CappyT/freedo/docs/API.md

# HTTP API reference

The freedo daemon serves a JSON API over HTTP. The Home Assistant integration uses it.
Any other client can use it too.

This file lists every route that `internal/daemon` registers and the rules that apply to
the routes. For the radio facts behind a rule, see [PROTOCOL.md](PROTOCOL.md).

## Conventions

### Address and authentication

- The daemon listens on `http_listen` (default `127.0.0.1:8080`). The flag `--addr` overrides it.
- Every request under `/api` carries `Authorization: Bearer <token>`. The daemon serves the
  [dashboard](OPERATION.md#dashboard) at every other path, without a token.
- The daemon reads the token from one source, in this order: the file of `--api-token-file`,
  the variable `FREEDO_API_TOKEN`, the file of the key `api_token_file`.
- The daemon removes spaces at both ends of the token. An empty token stops the start.
- The daemon compares tokens in constant time. A missing or wrong token gets `401` with
  `WWW-Authenticate: Bearer`.
- `--health-public` makes `GET /api/health` readable without a token, for a container
  health check. The default is off.
- `--ingress` makes the daemon accept the calls of the dashboard from the connection address
  `172.30.32.2`, the Home Assistant ingress gateway, without a token. It covers 59 method and path
  pairs only. Only the add-on start script sets it, and it has no effect unless `SUPERVISOR_TOKEN` is
  set. With the flag, the gateway also reaches the two routes of the
  [state export and import](#state-export-and-import) for a Home Assistant administrator. Every other
  request needs the token. See [Access](OPERATION.md#access).
- With no token, the daemon accepts a loopback address only and warns at start. An address
  that is not loopback stops the start. `--insecure-no-auth` removes this limit. With it,
  every host that reaches the port controls the plant.

To create a token:

```sh
openssl rand -hex 32 > freedo_api_token
chmod 600 freedo_api_token
curl -H "Authorization: Bearer $(cat freedo_api_token)" http://127.0.0.1:8080/api/stats
```

### Requests and answers

- A JSON body holds one value and no field that the route does not know. An unknown field
  or a second value gets `400`. A body over 64 KiB gets `413`. The limit is 1 MiB for
  firmware upload and for the debug routes.
- The server closes a connection that sends no complete header in 10 seconds.
- When a client closes a request, the daemon stops to wait for the engine and answers `503`.
  A command that the engine already took still runs.
- A command that cannot save its state in the database gets `500`.
  `PATCH /api/home`, the [program preset](#program-presets) routes, `PUT` and
  `DELETE /api/zones/{n}/schedule` and `POST /api/zones/{n}/window` store their state
  before they change the engine state. After a `500` the engine state is unchanged.
- A write that queues a radio message answers with the queue state of the target device.
  `GET /api/queue/{id}` shows the queue and the history, with the result of each message.
  A newer write to the same zone replaces a queued one that is not yet on air. The history
  shows the replaced message as `superseded`.
- After a `5.xx` answer from a device, the daemon repeats the write with a new message id
  and token.
- The daemon exits with code 1 when the live radio loop ends on an error. The service
  manager or the container restart policy then starts it again. The API keeps serving
  after a replay ends.

### Installation writes

Every write under `/api/install` answers `{"rev": N, "warnings": [...], <object>}`. Each
write accepts `rev` as an optimistic concurrency token. The label of a device is unique:
a write that repeats the label of another device gets `409` and names that device.
A delete that breaks a reference gets `409` and names the row that holds the reference.

Four routes carry a part of a wider route: `PUT /api/install/timezone`, `PUT /api/install/boiler`,
`PUT /api/install/devices/{ref}/label` and `PUT /api/install/devices/{ref}/zone`. They follow the rules
of the wider route and refuse every other field. `PUT /api/install/boiler` carries the options of the
boiler and of its flow limit: `boiler_max_power_kw`, `boiler_min_power_kw`, `boiler_max_gas_m3h`,
`boiler_min_gas_m3h`, `fuel_unit`, `flow_limit_c`, `flow_default_curve`, `flow_auto_adapt`,
`flow_curves`, `outdoor_max_age_sec`, `flow_hysteresis_c` and `flow_min_interval_sec`. A body with none
of them is `400`. `POST /api/pair/devices/{ref}` is `POST /api/pair`
with the target in the path and no `networkKeyHex`. The dashboard calls these, so
[Home Assistant ingress](../SECURITY.md#home-assistant-ingress) reaches them without a token and
does not reach the identity of the network or another network key.

`GET /api/install/devices/{ref}/removal` answers `{"rev", "device", "effects", "forceable"}`. It shows
what `DELETE` on the same device changes. Each entry of `effects` is `{"effect", "zone"}` or
`{"effect", "circuit"}`:

| Effect | Meaning |
|---|---|
| `member` | The zone loses the device as a member. One entry for each zone of the device. |
| `hot_water` | The zone is the hot water zone. |
| `last_member` | The zone has no member left. |
| `reporter` | The zone loses its demand reporter. |
| `measuring_device` | The zone loses the device that gives its temperature. |
| `heat_source` | The circuit loses its heat source. |

`DELETE` without `?force=true` gets `409` with the same `effects` while the list is not empty.
`force=true` releases the zone memberships. It never releases a heat source: `forceable` is `false`
then, and the circuit must change first. An empty list means that the delete needs no force.

### Credentials in answers

No route outside `/api/debug/*` and `GET /api/state/export` returns a credential. The credentials
are the device token, the session id, the challenge keys and the network key. The
[state export](#state-export-and-import) is the whole database, so it holds all of them.

- `Telemetry` of `/api/nodes` omits `auth_token`, `serial_id`, `cloud_session_id`,
  `challenge_key_rotate` and `0262`.
- `SessionIssued`, `SessionAdopted` and `SessionIssuedUnix` tell whether and when the daemon
  served a session. They do not carry the id. `SessionIssuedUnix` is the time the daemon last built
  an answer to `auth/token` or `auth/key`. A request that repeats the message id of the last one gets
  the stored answer, and the time does not move, so the time can be older than the last join.
  `SessionAdopted` has no time: it turns false when the daemon builds a new answer and true when a
  later request carries the session id. A device that leaves the installation loses the time and keeps
  `SessionIssued`.
- `GET /api/install` reports `network_key.present`. `PUT /api/install/network_key` and the
  field `networkKeyHex` of `POST /api/pair` receive the key and never return it.
- `GET /api/nodes/{id}/resource`, `/dbg/mem` and `/currentlog` return the raw device answer
  in hexadecimal, without a filter.

Identifiers are not credentials. The serial number, the EUI, the home id and the
coordinator EUI appear in `/api/install/*`, in `Serial` of `/api/nodes` and in the start
banner.

## Routes

`{id}` names a device by label, serial number or short address. `{n}` is a zone number.
`{ref}` names a device the same way.

### Read

| Route | Purpose |
|---|---|
| `GET /api/health` | State of the daemon, the radio and the devices, with alerts. |
| `GET /api/nodes`, `GET /api/nodes/{id}` | Devices with telemetry, battery, faults and settings. |
| `GET /api/zones` | Zones with members, demand, target, window state and external temperature. |
| `GET /api/circuits` | Heating circuits as the engine sees them. |
| `GET /api/boiler` | Boiler values, flow limit state, energy and gas estimate. |
| `GET /api/home` | Home and away state, the scheduled setpoint of each zone and the active preset. |
| `GET /api/stats` | Frame counters, node count and unhandled counts. |
| `GET /api/unhandled` | Counts of unhandled radio events by reason. |
| `GET /api/queue/{id}` | Queue and history of a device. |
| `DELETE /api/queue/{id}` | Drop the queue of a device. |
| `GET /api/early-start` | Early start state of all zones. |
| `GET /api/heatsource/capabilities` | Reads the heat source capabilities from the [boiler thermostat](#boiler-thermostat). |

### Zone commands

| Route | Purpose |
|---|---|
| `POST /api/zones/{n}/setpoint` | Set a manual overlay. |
| `POST /api/zones/{n}/off` | Switch the zone off with an overlay. |
| `POST /api/zones/{n}/auto` | Return the zone to its program. |
| `POST /api/zones/{n}/boost` | Start or stop the boost of a room. |
| `POST /api/zones/{n}/offset` | Set the temperature correction. |
| `POST /api/zones/{n}/window` | Open or close the window state from an outside source, or reset it. |
| `POST /api/zones/{n}/temperature`, `DELETE ...` | Give or remove an external room temperature. |
| `GET`, `PUT`, `DELETE /api/zones/{n}/schedule` | Read, write or remove the weekly program of one mode of one preset. |
| `GET`, `POST /api/presets` | List the program presets, create one. |
| `PATCH`, `DELETE /api/presets/{id}` | Rename or delete a preset. |
| `POST /api/presets/{id}/activate` | Switch the active preset. |
| `GET /api/presets/{id}/schedules` | Read every program of one preset, zone by zone. |
| `GET`, `PUT /api/zones/{n}/early-start` | Read or switch the early start. |
| `DELETE /api/zones/{n}/early-start/model` | Delete the learned heat-up model. |
| `GET /api/zones/{n}/episodes` | Recorded heating and cooling episodes. |
| `GET /api/zones/{n}/pid-suggestion` | Suggested controller gains from the episodes. |
| `PATCH /api/home` | Switch the whole home between home and away. |

### Device commands

| Route | Purpose |
|---|---|
| `POST /api/nodes/{id}/setpoint` | Low-level setpoint write to one device. |
| `POST /api/nodes/{id}/mode`, `.../overlay` | Low-level overlay mode (`overlay` is an alias). |
| `POST /api/nodes/{id}/openwindow`, `.../ow` | Low-level window write (`ow` is an alias). |
| `POST /api/nodes/{id}/boost` | Low-level boost. |
| `POST /api/nodes/{id}/childlock` | Lock or unlock the controls of a valve. |
| `GET`, `PUT /api/nodes/{id}/display` | Read or write the display settings of a valve. |
| `POST /api/nodes/{id}/identify`, `.../beep` | Make a valve or the wall thermostat signal itself (`beep` is an alias). |
| `POST /api/nodes/{id}/calibrate` | Start the motor calibration of a valve. |
| `POST /api/nodes/{id}/reboot` | Restart a device. The body is `{}` or `{"id": N}`. The device keeps its key and joins again. |
| `POST /api/nodes/{id}/extui` | Write the external interface endpoints. |
| `POST /api/nodes/{id}/config` | Write chosen `d/config` tags. |
| `DELETE /api/nodes/{id}/config/offlineScheduleEnabled` | Remove the per-device offline schedule value. |
| `PUT /api/nodes/{id}/schedule` | Write the home program of the heating zone of a device, or the document of a device in no heating zone. |
| `GET`, `POST`, `DELETE /api/nodes/{id}/fw` | Read the firmware state, start or cancel a transfer. |
| `GET /api/nodes/{id}/currentlog` | Read the device log. |
| `GET /api/nodes/{id}/dbg/mem?adr=&len=` | Read device memory (`refresh=1` forces a new read). The read stays inside flash `0-7ffff`, FICR and UICR `10000000-10001fff`, SRAM `20000000-2000ffff` or external flash `80000000-ffffffff`. |
| `GET`, `POST /api/nodes/{id}/dbg/stats?f=` | Valve debug statistics, `f=10` for the state times or `f=11` for the radio counters. `POST` queues `POST d/dbg/m?f=N`. `GET` sends nothing: it answers `pending`, the code of the last answer, and the last 2.05 decoded under `stats` with its `received_at`. The code `2.05+more` marks an answer that announces more Block2 blocks: freedo does not follow it, because a new POST would run the function again. For `f=10`, `share` gives the awake, TX and RX time in percent between the last two 2.05 answers. It is absent when they are 36 h apart or more, or when their awake and sleep ticks disagree with the clock of the daemon by more than 10 s plus 10 %, as after a restart of the valve. For `f=11`, `delta` gives `interval_s` and the change of each counter between the last two 2.05 answers, without `023d` and `023e`. Most counters carry their low 16 bits and wrap at 65536, so a single value counts from an unknown start: only the change means something. A restart of the valve, or 65536 counts or more between two answers, gives a wrong change. The wall thermostat is refused. |
| `GET /api/nodes/{id}/resource?path=&query=` | Read any resource of a device, except `d/dbg/m`. |

### Boiler, environment and pairing

| Route | Purpose |
|---|---|
| `POST /api/boiler/dhw` | Set the hot water temperature overlay. |
| `POST /api/boiler/flow` | Set the flow limit of a circuit (the [boiler thermostat](#boiler-thermostat) by default). |
| `POST`, `DELETE /api/boiler/gas/meter` | Record or remove a gas meter reading. |
| `POST /api/outdoor` | Give the outdoor temperature. |
| `GET`, `POST /api/pair/window` | Read, open or close the pair window. |
| `POST /api/pair` | Send the `d/pair` command to a device. |
| `POST /api/pair/devices/{ref}` | Send the `d/pair` command to the named device, under the network key of the installation. No body. |
| `POST /api/radio/calibrate` | Forget the stored receiver calibration and measure it again. No body. |

### Statistics

| Route | Purpose |
|---|---|
| `GET`, `PUT /api/history` | Read or change the statistics: the switch, the fuel price and the currency. |
| `GET /api/history/zones/{number}?date=` | The samples and the heat-ups of one zone over one local day. |
| `GET /api/history/energy?from=&to=` | The fuel, heat and burner totals of each day. |
| `GET /api/history/advice?days=` | Where the fuel of the last 7, 28 or 90 days went, and the heat-loss model of the house. |

See [Statistics](#statistics).

### Installation

| Route | Purpose |
|---|---|
| `GET`, `PATCH /api/install` | Read or change the installation and its options. |
| `PUT /api/install/network_key` | Write the network key (only while no device is declared). |
| `PUT /api/install/timezone` | Write the time zone alone: `{"timezone": "Europe/Rome"}`, `null` to follow the host. |
| `PUT /api/install/boiler` | Write the boiler and flow limit options alone: see [Installation writes](#installation-writes). |
| `GET`, `POST /api/install/devices` | List or declare devices. |
| `GET`, `PATCH`, `DELETE /api/install/devices/{ref}` | Read, change or delete a device. |
| `PUT /api/install/devices/{ref}/label` | Rename a device: write the label alone. |
| `PUT /api/install/devices/{ref}/zone` | Write the zone the device answers to, alone: `{"zone": 3}`, `null` to remove it. |
| `GET /api/install/devices/{ref}/removal` | Show what a removal changes. |
| `GET`, `POST /api/install/zones` | List or declare zones. |
| `GET`, `PATCH`, `DELETE /api/install/zones/{number}` | Read, change or delete a zone. |
| `PUT`, `POST /api/install/zones/{number}/members` | Replace the members, or add one. |
| `DELETE /api/install/zones/{number}/members/{ref}` | Remove one member. |
| `PUT`, `DELETE /api/install/zones/{number}/reporter` | Set or clear the demand reporter. |
| `PUT`, `DELETE /api/install/zones/{number}/measuring` | Set or clear the measuring device. |
| `GET`, `POST /api/install/circuits` | List or declare circuits. |
| `GET`, `PATCH`, `DELETE /api/install/circuits/{id}` | Read, change or delete a circuit. |

### State

| Route | Purpose |
|---|---|
| `GET /api/state/export` | Download a snapshot of the state database, as one file. |
| `POST /api/state/import?confirm=true` | Replace the state database with an exported file and restart the daemon. |

See [State export and import](#state-export-and-import).

### Debug

`--debug-api` or `debug_api: true` enables these routes. They decrypt any frame that a
caller sends and stream live traffic. Leave them off in normal use.

| Route | Purpose |
|---|---|
| `POST /api/debug/dissect` | Interpret a frame. |
| `POST /api/debug/decrypt` | Decrypt a frame. |
| `GET /api/debug/rx` | Stream received frames. |

## Installation model

A device is a physical node. A zone is a room or the hot water service. A circuit joins
one or more zones to a heat source. The three have separate identifiers.

- A heating zone holds valves. It can hold a wall thermostat as the measuring device.
- The hot water zone holds the wall thermostat.
- `measuring_device` selects the measurement the zone uses. `reporter` selects the member
  that publishes the aggregated demand. The loader rejects a missing or ambiguous reference.
- A zone number can be sparse. A valve answers to one logical zone number. The `zone` field
  of the device states it. The circuit number does not depend on the zone number.
- A circuit needs a heat source, and the heat source must be a wall thermostat. A heating
  zone should have a circuit. Without one, the zone configuration for its valves has no
  circuit tag `6060` and no heat source among the members, and the install check warns about
  the zone. No device has run a zone configuration of this kind.
- The order of the members matters: the zone configuration document has other bytes with
  another order.

The installation is stored in the SQLite database. The tables are `install` (key-value
options), `net_key`, `device`, `circuit`, `zone` and `zone_member`. Each write is one
transaction that applies the rows, rebuilds the installation, validates it and raises
`install_rev`. The engine gets the installation after the commit.

The database holds more than the installation. It also keeps the desired state of the
devices and the learned state. These are the away state, the program presets with the home
and away programs of each zone, the program
blocks of each zone, the early start models, the adapted flow limits, the last external
room temperature of each zone the coordinator owns, the boiler counters, the resume points of the frame counters
and the radio calibration. The node state, the learned zone members and the command queue
are caches. Device reports rebuild them, so a restart repairs them.

The database uses the pure Go driver `modernc.org/sqlite`, WAL mode and
`synchronous=FULL`. It migrates forward only. A damaged, foreign or newer database stops
the start with an error. `SIGTERM` and `SIGINT` run the same orderly stop. It ends in
less than nine seconds, below the ten seconds of `docker stop`.

On the first start with an empty database, the daemon creates the 16-byte network key, the
coordinator EUI and a home id. It never prints the key. A network key that differs from
the one of an existing network makes every frame of that network fail the MIC check.

### Installation options

`PATCH /api/install` writes these options. A `null` removes the value where the option
allows it.

| Option | Default | Meaning |
|---|---|---|
| `home_id`, `coordinator` | generated | Identity of the network. Change only while no device is declared. |
| `utc_offset_min`, `timezone` | host zone | Clock of the devices (tag `02b2`) and of the programs. A set `utc_offset_min` wins over `timezone`, and a loadable `timezone` (IANA name) wins over the host zone. `GET /api/health` shows the source in `timezone`. |
| `utc_push_spacing_sec` | 60 | Spacing of the offset writes to the valves. Each write homes the motor. |
| `offline_schedule` | `true` | Tag `02b3` for every device without its own value. |
| `external_window_max_sec` | 7200 | Cap of a window state from an outside source. |
| `room_temp_max_age_sec` | 1800 | Age at which an external room temperature expires. |
| `low_battery_cell_mv` | 1100 | Battery alarm threshold per cell. |
| `offline_after_sec` | 3600 | Silence after which a device is `offline`. |
| `flow_limit_c` | none | Flow limit of every circuit that no manual value, curve or adaptation sets, 30 to 75 C. It is also the manual maximum that the default curve reduces. While it is unset, such a circuit is served no limit: see [Flow limit](#flow-limit). A `null` clears it. |
| `outdoor_max_age_sec` | 3600 | Age at which the outdoor temperature expires. |
| `flow_hysteresis_c`, `flow_min_interval_sec` | 1, 1800 | Smallest change and shortest interval of the served flow limit. |
| `flow_curves`, `flow_auto_adapt` | none, `false` | Weather curve per circuit, and the automatic adaptation. |
| `flow_default_curve` | `false` | Built-in weather curve for every circuit without a curve of its own. It needs `flow_limit_c`: see [Flow limit](#flow-limit). |
| `early_start_min_episodes`, `early_start_max_lead_sec` | 3, 7200 | Early start thresholds. |
| `boiler_max_power_kw`, `boiler_min_power_kw` | none, 0 | Boiler output at 100 % and 0 % modulation. |
| `boiler_max_gas_m3h`, `boiler_min_gas_m3h` | none | Fuel flow at 100 % and 0 % modulation, in `fuel_unit` per hour. |
| `fuel_unit` | `m3` | Unit of the fuel flow and counter: `m3`, `l` or `kg`. `null` takes `m3`. |
| `router_gateway`, `router_dns` | `0.0.0.0` | IPv4 gateway and DNS address that the Router Advertisement carries, as dotted quads. `null` or an empty string takes `0.0.0.0`. Not verified on a device. |

### Zone options

`PATCH /api/install/zones/{number}` writes these options.

| Option | Default | Meaning |
|---|---|---|
| `open_window_detection`, `open_window_duration_sec` | `true`, 900 | Window detection of the valves and the time the zone stays open. |
| `early_start` | `false` | Early start for the zone. |
| `device_overlay_end`, `device_overlay_end_sec` | `until_next` | End rule of a change made on a device: `manual`, `until_next` or `timer` with a duration. |
| `offset_mode` | `config` | How the temperature correction reaches the zone: `config` or `dbg2`. |
| `owner` | `device` | Who owns the zone: `device` (the elected demand reporter) or `coordinator`, which runs the zone controller on the external room temperature. Only a heating zone takes it. Unverified on air. |
| `pid` | 1000, 500, 1500 | Controller gains `kp`, `ki`, `kd` of the valve, each 0 to 65535. `kp` and `ki` cannot both be 0. `null` restores the defaults. |
| `away_temperature_c` | `null` | Temperature in away, 5 to 25 C with at most two decimals. `null` and 5 mean off in away. The hot water zone refuses it. An away program of the zone replaces the fixed temperature while the home is away. |
| `radiator_w` | `null` | Total nominal radiator power of the room in watts, the sum of the data-sheet values, 100 to 20000. `null` clears it. Optional. A consumption advisor uses it to split the consumption between rooms. The hot water zone refuses it. |
| `shared_space` | `null` | Short name of the air volume the room shares with other rooms (an open space): 1 to 32 characters of letters, digits, space, `-` or `_`, trimmed. `null` clears it. Optional. Zones with the same name share one air volume. The consumption advisor sums them for its heat-loss figure and gives one suggestion for the group. The fuel split still lists each zone. The hot water zone refuses it. |
| `ha_area` | `null` | Home Assistant area of the zone, `{"id": "...", "name": "..."}`, each 1 to 255 bytes with no control character. `null` clears it. The integration writes it and the dashboard shows it. The daemon never acts on it. `GET /api/zones` shows it in `declared[].haArea`. |

A `pid` change gives the zone document a new ETag and writes nothing to the valve. The
valve rereads the document after its hourly check, applies the gains and resets the
integrator. A change of `away_temperature_c` during away rewrites that zone at once when it
has no away program. A
change at home writes nothing and applies from the next away.

## Zones

### Zone commands

The daemon chooses the device to write. The commercial coordinator writes `z/s?id=N` only
to the reporter of the zone, even when the reporter is the wall thermostat. The other
members take the block from the echo of the reporter. A zone without a reporter and with
one member writes that member. With more members, `setpoint`, `off`, `auto` and `boost`
write every member. The answer then holds the members in `target`, separated by commas
(serial number, or EUI when a device has none), and the sum of their pending downlinks in
`pending`. The hot water zone writes the wall thermostat.

- `POST /api/zones/{n}/setpoint` with `{"setpointC": 21, "mode": "manual"}` sets an overlay.
  A room accepts 5 to 25 C. Hot water accepts 30 to 65 C.
  - `mode` is `manual`, `until_next`, `timer` (with `durationSec`) or `until_auto_change`.
  - `until_next` lasts until the next block of the program in force: in away, the away
    program of a zone that has one. Without a program in force it does not end.
  - `until_auto_change` lasts until the next program block or the next switch between home
    and away, whichever comes first. On air it is `6240=1`. A capture shows it for rooms.
    For hot water the value is not verified. The daemon keeps the rule and the deadline in
    the database. `device_overlay_end` does not accept it.
  - `timer` needs `durationSec`, 1 to 604800 (7 days). The other modes refuse it.
- `POST /api/zones/{n}/auto` returns the zone to its program.
- `POST /api/zones/{n}/off` with `{"mode": ...}` switches the zone off with an overlay
  (`6260=0`, no `6280`). `mode` takes the values of `setpoint`.
- `POST /api/zones/{n}/boost` with `{"on": true}` sets a room to 25 C for 30 minutes, then
  returns it to the program.
- `POST /api/nodes/{id}/setpoint` is the low-level form. It needs `tempC`. `tempC` and
  `sched` stay in 5 to 25 C, because a value outside wraps in the 16 bits of the tag.

### Overlays made on a device

A person who turns the wheel of a valve sends `PUT h/<home>/z/N/overlay`. The daemon answers
`2.05` and writes nothing. The end rule does not travel on air, so the daemon applies the
`device_overlay_end` rule of the zone:

- `manual` does not end.
- `until_next` ends at the next block of the program in force, the away program in away.
  Without one it does not end.
- `timer` ends after `device_overlay_end_sec`.

At the end, the daemon writes `6240=0` and the program setpoint to the writer of the zone.
`POST /api/zones/{n}/auto` cancels the overlay. The deadline survives a restart.

The elected reporter sends `DELETE h/<home>/z/N/overlay` when `6240` returns to 0 on the
device. The daemon answers `2.05`, returns the zone to automatic, drops the deadline and
replaces queued writes that repeat the old overlay.

### Zone target in `GET /api/zones`

`declared[].writer` names the device that receives commands. `declared[].target` holds
`targetC`, `source` (`program`, `overlay`, `boost`, `window` or `away`), `overlay`
(`kind`, `rule`, `on`, `setpointC`, `endsAt`), `programC`, `programOff`, `hasProgram`,
`boost`, `known` and `on`.

- `targetC` is `null` when the device follows a value of its own: open window, away without
  a temperature, an off overlay or a program block that is off. It is also `null` on a zone
  that has no program and whose zone cache holds no `6200`.
- `hasProgram` is `true` while a weekly program is in force for the zone: in away, the away
  program of a zone that has one, else the home program
  ([program presets](#program-presets)). It is `false` for a zone with no program in force,
  also for a zone with only an away program while the home is at home. `source` is
  `program` in both cases, because it only says that no overlay, window or away state
  applies. Read `hasProgram` to tell a zone that follows a program from a zone that has
  none.
- `programC` and `programOff` are the block of the program in force: in away, the block of
  the away program of a zone that has one. Without a program, `programC` is the `6200` that
  the zone cache holds (the last write or
  member report that carried it), or `null` when the cache holds none. A zone with no
  program and no `6200` has `targetC` and `programC` at `null`. The daemon writes such a zone
  only at a switch between home and away and at a command, never at a block change or at the
  start, and its writes at home carry no `6200`.
- `overlay.kind` follows `6240`: `manual`, `until_next` or `until_auto_change`. A timer
  appears as `until_next`, because the air has no timer.
- `overlay.rule` is the rule the overlay runs under: `manual`, `timer`, `until_next` or
  `until_auto_change`. `endsAt` is the deadline the daemon keeps, `null` without one. The
  remaining time is `endsAt` minus now.
- `GET /api/zones` reports the mode of each zone in `demand`.

### Home and away

`GET /api/home` returns the state, the scheduled setpoints and the active preset in
`preset`. `scheduledOff` lists the
zones whose current block is off. `PATCH /api/home` with `{"away": true}` switches the
whole home and writes each zone once. The state survives a restart and appears in
`/api/health`.

- In away, a zone with an away program follows it: the daemon evaluates it on the program
  clock and writes each block change as `6160=2`, `61e0=1` and the block temperature in
  `6200`, or `61e0=0` for an off block. The hot water zone writes its away blocks the same
  way, instead of off in away. No capture shows the thermostat take this shape without an
  overlay: it is not verified on a device.
- In away, a change that moves the away value of a zone writes that zone once, also when
  its block keeps the same temperature: an away program put or removed, or a preset
  activation that adds or drops one. A hot water zone that loses its away program returns
  to off in away. The daemon stores the away value each zone received with its block.
- Without an away program, a heating zone keeps the away fallback: with
  `away_temperature_c` above 5 it receives `6160=2`, `61e0=1` and the temperature in `6200`;
  without the field, or at 5, it receives `61e0=0` and no `6200`.
- A write to a zone without an overlay carries `6440` when the effective target changes.
  A running overlay keeps its block, and the write carries no `6440`. The return to home
  writes the program block again.
- An overlay with the rule `until_auto_change` ends at each switch between home and away.
  The zone then receives the return to program with the new home state.
- Hot water follows away like a room. On its program and without an away program it
  switches off in away. A permanent
  manual overlay (for example 48 C) stays on in away.

### Weekly schedule

`GET`, `PUT` and `DELETE /api/zones/{n}/schedule` read, write or remove the weekly program
of the zone. Each zone holds two modes: the `home` program it follows at home and an
optional `away` program it follows while the whole home is away. The query names the mode
(`mode=home|away`, `home` by default) and the [program preset](#program-presets)
(`preset=<id>`, the active one by default). The answer of `GET` and `PUT` carries the
programs with their `mode` and `preset`. `GET` reads the program store, which the served
documents follow.

- `PUT` writes one or more day programs with a day mask and switch points. A document
  over 64 KiB gets `413`. A `mode` outside `home|away` gets `400`, an unknown preset id
  `404`.
- `DELETE` of the away program returns the zone to the away fallback. `DELETE` of the home
  program of the active preset leaves the zone without a program: the daemon stops its
  block changes, the served document of every member of a heating zone is dropped, and its
  next fetch reads `2.03` and keeps the program it runs, as a zone that never had one.
  A `DELETE` of a mode without a program gets `404`.
- The served `sched` document of a heating member derives from the home program of the
  active preset. A `PUT` on it fans the document out to every member, and each member
  receives the same document with its next GET. An away program, and the program of a preset
  that is not active, stay daemon-side.
- A member fetches the program only with `offline_schedule` on. When the document ETag of
  a member changes and its tag `02b3` is 1, the daemon queues an empty `POST d/sched`. The
  device then fetches at its next report cycle. With `02b3` at 0 the daemon queues nothing.
- A device that has no coordinator answer for 25 minutes applies the program by itself
  (needs `02b3` at 1).
- The daemon checks these rules. Every mask selects at least one day. Masks share no day and
  cover seven days. Every program starts at minute 0, and its minutes increase up to 1439. Each
  encoded program stays within 255 bytes. A heating setpoint stays in 5 to 25 C, also in an off
  block, in either mode.
- The daemon evaluates programs, early start and `until_next` on the clock of the devices:
  UTC plus the served `02b2`. The clock follows `utc_offset_min`, else `timezone`, else the
  zone of the host. A program minute is a local time, also on a day with a clock change.
- The hot water program stays in the daemon. No device downloads it, in either mode. The
  setpoint stays in 30 to 65 C. At each block change of the program in force the daemon
  writes the wall thermostat with `6200` and
  `61e0=1`, or `61e0=0` for an off block.
- The daemon stores the block each zone received. After a restart it writes once each zone
  whose program in force moved while the daemon was down. It also stores zone rewrites that
  are queued and not confirmed, and queues them again once after a restart.
- A device that moves to another heating zone receives the home program of the new zone in
  the active preset. A zone without one gives the device `2.03`, and it keeps its program.
- At start the daemon removes the stored `sched` document of the hot water thermostat when
  no heating program explains it, and logs this.

`PUT /api/nodes/{id}/schedule` on a member of a heating zone writes the home program of
its first heating zone in the active preset, as a `PUT` on the zone does: every member
receives the document. A zone has one program, so a document of one member alone would
leave the devices on a program the daemon does not follow. A device in no heating zone
receives the document alone.

### Program presets

A preset holds the home program and the optional away program of every zone, the hot water
zone included. Exactly one preset is active: the daemon evaluates its programs, and the
served `sched` documents derive from its home programs. A schedule write without
`preset=<id>` names the active preset.

- `GET /api/presets` lists the presets with `id`, `name` and `active`.
- `POST /api/presets` with `{"name": "Winter"}` creates a preset with a copy of every
  program of the active one; `copy_from` names another source. The name is unique without
  case: a repeat, in a create or a rename, gets `409`.
- `PATCH /api/presets/{id}` with `{"name": "..."}` renames one. `DELETE` removes a preset
  with its programs; the active preset and the last one answer `409`. An unknown id gets
  `404` on every preset route.
- `POST /api/presets/{id}/activate` switches the active preset. One action serves the home
  programs of the preset to the zone members — a document with unchanged bytes takes no
  fetch trigger, and a zone without a home program loses its served document — and writes
  once each zone whose block in force moved, in the home or away shape of the moment.
  The write is a program block write and carries no `6440`. Activating the active preset
  changes nothing. The active id is stored first: a failed save gets `500` and keeps the old
  preset. A member that refuses its document does not undo the switch: the answer is `500`
  and names the preset that is active, every other member and zone still takes its document
  and its write, and the next start serves the documents again.
- `GET /api/presets/{id}/schedules` reads one preset whole: `preset` (`id`, `name`,
  `active`) and `zones`, one row per declared zone in installation order with `zone`,
  `name`, `kind`, `home` and `away` (the programs in the form of the schedule routes, `null`
  for a mode without a program) and `inForce`. `inForce` is the block the preset holds now
  in the current home state, `{"mode": "home"|"away", "setpointC": 21, "off": false}`, or
  `null` when the preset holds no program in force for the zone: in away, a zone without an
  away program keeps the away fallback, which no preset holds. Comparing `inForce` of a
  preset with the one of the active preset gives the zones an activation writes at once.
- `GET /api/home` reports the active preset in `preset`, with `id` and `name`.
- On the first start the daemon builds the preset `Default` from the programs it already
  holds, and makes it active: the heating programs from the served `sched` documents. A document that does not decode or breaks the week
  rules stays out and is logged. The preset, its programs and the active id go into the
  database in one transaction: a start that fails part way leaves no preset, and the next
  start migrates again. Only preset rows are written in this, so a restart serves the same
  documents and ETags as before.
- The hot water program of an older daemon moves into every preset that holds no home
  program for the hot water zone, at start or at an installation change, once the
  installation declares a hot water zone. Until then it stays in the database.
- A stored program that does not decode or breaks the week rules is logged and skipped at
  start. A database with presets and no valid active id starts on the first preset and logs
  the inconsistency.
- At each start and after each installation change the daemon serves the home programs of
  the active preset again. A member whose document differs receives the program of its
  zone and a fetch trigger, and a member of a zone without a home program loses its
  document. A document with unchanged bytes takes nothing, so a start after an upgrade
  writes nothing on air.
- A program belongs to its zone. A zone delete, or a change of the zone kind, drops the
  programs of that zone from every preset, so a zone later declared under the same number
  starts with none. An installation written over the whole database (seed or import)
  drops the programs of each zone number it no longer declares or declares with another
  kind, and keeps the others.
- The daemon has no season calendar. An outside automation, for example Home Assistant,
  switches the presets.

### Window

`POST /api/zones/{n}/window` with `{"open": true}` or `{"open": false}` sets the window
state from an outside source, for example a Home Assistant sensor.

- The daemon writes `62e0` to the demand reporter when the zone state changes. The other
  members take the block from the echo of the reporter. Without a reporter, or with an
  offline one, the daemon writes every member. Each write carries the home state, the program
  `6200` and the active overlay.
- A member that does not accept the write is retried every 30 seconds, 40 times. The daemon
  then lists it in `undelivered`. The list is not stored: after a restart the daemon retries
  the writes that are due.
- The valve detector opens the same window with the report `z/ow` when the zone has
  `open_window_detection`. The window closes after `open_window_duration_sec`.
- A member that clears its own `62e0` sends `DELETE h/<home>/z/N/ow`. The daemon answers
  `2.05`, drops that source and, when the zone closes, writes `62e0=0` to the zone writers.
- `{"open": false, "reset": true}` is the reset a person asks for. It drops every source, also
  the valve detector before `open_window_duration_sec`, and the daemon writes `62e0=0` at once.
  The valve does not report again for the same detection, and a new detection opens a new
  window. A sensor that closes sends `{"open": false}` without `reset`: it ends the outside
  source only, so it does not cancel what a valve detected. `reset` with `"open": true` is
  refused with 400.
- The zone stays open while one source keeps it open. An outside window without a close ends
  after `external_window_max_sec`. An open on a zone that the outside source already holds
  restarts that time, keeps `since` and writes nothing to the devices. So a source that
  repeats the open before `deadline` keeps the zone open, and the zone closes by itself when
  the source stops.
- `open`, `source`, `since` and `deadline` are stored and appear in `GET /api/zones` and, for
  each zone, in `/api/health`. The hot water zone has no window.

### Temperature correction

`POST /api/zones/{n}/offset` with `{"offsetC": -0.7}` sets the correction. The zone option
`offset_mode` selects how it applies.

- `config` writes tag `0140` in the whole `PUT d/config`, as the commercial bridge does. The
  valve rereads the configuration and homes its motor on each change. The wall thermostat
  ignores the document of a `d/config` write. The daemon puts `0140` in the served document
  under a new ETag, and the thermostat rereads it. The answer carries `"queued": false`,
  `"served": true` and `"reread"`.
- `dbg2` writes the single record `0140` with `PUT d/dbg2/tlvs`. On the `2.04` of the valve
  the daemon puts it in the served `d/config` under the same ETag. A `4.xx` answer or a lost
  write leaves the document unchanged. The valve does not home. No capture shows this on
  air. No evidence shows the wall thermostat apply a `d/dbg2/tlvs` record, so its zone refuses
  this mode.

To correct a zone from a room thermometer, give the zone to the coordinator (see "Coordinator
as zone owner"), or let a Home Assistant automation or Better Thermostat write the correction
through the Offset number entity.

### Coordinator as zone owner

The zone option `owner` set to `coordinator` names the daemon as the owner of a heating zone
in its zone document: tag `63a0` (owner) and tag `6040` (measuring endpoint) carry the
coordinator endpoint, the members and their report endpoints stay as they are. On air the
owner runs the zone controller on its own sensor and publishes the measure on `z/p`; the other
members follow its demand, the way a second valve follows the first and a valve follows the
wall thermostat where that one owns the zone. The commercial wireless temperature sensor works
this way.

With the daemon as owner:

- The daemon runs the controller of the valve, `Kp*(SP-T)/2000 + Ki*integ/30000 -
  Kd*(T-Tref)/2000` in centi-degrees with the gains of `pid`, once a minute, on the external
  room temperature while it is fresh, else on the calibrated temperature of the measuring
  device. Without a target (an open window, an off block, away with no temperature) the demand
  is 0 and the integrator restarts. The daemon stores the controller state once a minute and at shutdown: a restart within 10
  minutes restores it, so the stop of a backup does not reset it. After a longer stop the
  controller starts from zero, as a valve does after each read of the zone document. A change of the source
  (external reading to device or back) restarts it too: the gap between the two sensors is no
  room change.
- The zone elects no demand reporter: `DemandReporter` names none while the coordinator owns
  the zone, so the `015e` record of each valve carries the plain role `0x05` and the reload that
  follows the change queues the `d/config` write. The declared `reporter` row stays and takes
  the elected bit back when the owner returns to `device`. An elected valve keeps running its
  own controller on its own sensor whatever the zone document says: on the plant it published
  100 % on a satisfied room from the step between the two sensors, and the thermostat fired the
  boiler on it.
- The daemon answers `GET z/p?lid=N` of the zone with its own measure, tags `4060`, `40a0` and
  `0135`, and pushes it to every member as `PUT z/p?lid=N` on the zone plane once a minute,
  under the Max-Age of 1800 s the measure carries. The wall thermostat observes the measure of
  each owned zone and takes the demand from the observe notifications alone. The zone
  document names `/z<N>` as the measuring endpoint (tag `6040`) of an owned zone, `N` in
  decimal without leading zeros (`/z1`, `/z8`, `/z10`). A zone that a device owns keeps
  `/z/p`. The thermostat keeps one outgoing observe subscription per peer, port and path.
  With one path for all owned zones, each registration would replace the one before, so one
  zone would keep its observer. With one path per zone the thermostat holds one registration
  per owned zone. The path field of the thermostat holds 4 characters with the slash, so `N`
  has at most 2 digits. Zone numbers stop at 31, so no extra check is needed. A GET of
  `z<N>` with Observe 0 from a member or the heat source of zone `N` gets the measure of zone
  `N` and registers the device under the token of the GET. From any other device, or for a
  zone the daemon does not own, the daemon answers the bare `2.05` and registers nothing.
  A thermostat that still holds an older zone document reads `z/p` with no query. The daemon
  answers it with the measure of the owned zone the thermostat serves, the one with the highest
  demand when there are several. The answer to a GET with Observe 0 carries the Observe option
  and registers the thermostat. The daemon then sends it a NON `2.05` notification under the
  token of the registration each time the measure changes, and at least every 10 minutes. An
  answer without the Observe option ends the observation: the zone goes to its fallback and the
  thermostat GETs again every two minutes. The thermostat reloads its observe slots only after
  a `2.05` of `d/config`, so the ETag of its `d/config` hashes the measuring endpoint of each
  heating zone it serves. A change of `owner`, or a new form of the endpoint after an update,
  moves the ETag and sends the thermostat its `d/config` re-read trigger: it reads the new
  zone documents within seconds and registers on the new endpoints.
- Only an owned zone takes `POST /api/zones/{n}/temperature`. One request can carry `owner`
  and `offset_mode` together.
- `declared[].owner` in `GET /api/zones` shows `mode`, and for an owned zone `tempC`, `source`
  (`external` or `device`), `demandPct`, `pushedAt` and `observers`: one entry per observe
  registration, with `device`, `token` (hex), `seq` (the last Observe value sent) and
  `notifiedAt`. The daemon stores the registrations, so after a restart the first step
  notifies each observer under its token with the next `seq`.
- The daemon logs every zone-plane request a member addresses to it for an owned zone, with
  the method, the URI, whether it carries the observe option and the body of a measure. It logs
  one line per observe registration and one per notification.

Seen on a plant, one valve zone. An elected valve reads the new zone document within minutes
of the PATCH, sends `PUT z/p?lid=N` to the coordinator twice a minute, once with its own sensor
and its own controller, once echoing the pushed measure, never with an observe option, and
answers each push with `2.05` and `62a0=00`. Its demand stays its own: the match with the
pushed demand in a first run was two equal controllers started together. With the plain role
`0x05` the valve asks the coordinator `GET z/s?lid=N` and `GET z/p?lid=N`, stops sending its
own measures and echoes the pushed measure alone, demand included. The thermostat runs on the
plant with zones 1, 3 and 8 owned. Open: whether the observe slot index of the thermostat and
the `lid` index of its `PUT z/p?lid=N` name the same zone. A static reading of the firmware
cannot show it.

### External room temperature

`POST /api/zones/{n}/temperature` with `{"tempC": 20.4, "source": "Soggiorno thermometer"}`
gives the zone the room temperature that an outside sensor measures. `DELETE` removes it.
`tempC` stays in -10 to 50 and the daemon rounds it to 0.01 C. `source` is optional: it names
the sensor for display, at most 255 bytes with no control character. A push without it clears
the name. A zone must be a heating zone with the coordinator as owner. Hot water gets `400`, an unknown
zone `404`, and a zone its device owns gets `409`. The daemon remembers that refused push in
memory (the time and the `source`) and shows it as `refused`. The last reading survives a
restart of the daemon while it is fresh.

While the reading is fresh, the zone controller regulates on it (see "Coordinator as zone
owner") and the zone reports it as its temperature. An older reading than
`room_temp_max_age_sec`, or a `DELETE`, ends it: the controller then reads the measuring
device. A zone that leaves the coordinator forgets the reading.

`declared[].externalTemp` in `GET /api/zones` shows `tempC`, `at`, `ageSec`, `source`, `stale`,
`inUse`, `deviceC` and `refused`. `deviceC` is the temperature the zone reports from its
devices. `refused` is `{"source": string|null, "at": RFC3339, "ageSec": int}` for the last
push that got `409`, or `null`. An accepted push, a `DELETE`, the coordinator as owner and the
removal of the zone clear it. A refusal older than `room_temp_max_age_sec` does not show. It
also shows on a zone that has no reading, so a mapping on a zone its device owns is visible. A
restart of the daemon clears it. `inUse` says the reading drives the zone: the controller, the
early start, the flow adaptation and the plant episodes read `tempC` instead of `4060`, and the
zone reports `tempC` as its temperature. While `inUse` is true, a manual offset write keeps a
running heat-up episode and a running plant heat episode, because the write moves `4060` and
not the external reading (see Early start).

### Early start

The daemon learns the heat-up rate (C/h) of each heating zone. No device firmware starts a
block early.

- An episode starts when the zone target rises at least 0.5 C above `4060`. It ends when a
  report reaches the target. The daemon discards an episode that has any of these: an open
  window, an overlay, away, an off block, a target change, a correction change, no report for
  `offline_after_sec`, no demand `40a0`, a length over 6 hours, or a rate outside 0.1 to 10 C/h.
- A correction change is a manual offset write. It moves `4060` by the delta, so the learner
  reads the step as the plant. It rejects a running episode only when the learner reads
  `4060`. On an owned zone with a fresh external reading the learner reads that reading, which
  the write does not move.
- The model keeps the last 10 episodes and uses the median. With a fresh outdoor temperature
  it prefers the episodes nearest to that temperature. It is stored in the `meta` table.
- With at least `early_start_min_episodes` episodes, the daemon sends the `6200` of a warmer
  block `(target - temperature) / rate` before it starts, at most `early_start_max_lead_sec`
  before. It plans from the home program of the active preset, acts only at home, without an
  overlay and without an open window, and never on
  the hot water zone. It stores the running early start.
- `PUT /api/zones/{n}/early-start` with `{"enabled": true}` switches it on. It is off by
  default. `PATCH /api/install/zones/{n}` writes the same `early_start`.
- `GET /api/zones/{n}/early-start` and `GET /api/early-start` show the rate, the episodes,
  the last update and the next early start. `DELETE .../early-start/model` clears the model.

### Plant episodes and controller suggestion

The daemon records plant episodes for an offline fit of the valve controller. Each zone
report adds a sample with `4060`, `40a0`, `4160` and the fresh outdoor temperature. On a zone
the coordinator owns, each controller step adds the sample instead, with the temperature and
the demand of that step: the members echo pushed measures minutes late, between fresh ones.
Until the controller has a temperature (the first step after a restart), the zone takes no
sample. Each episode stores `owner`, who ran the zone controller, and `onset: true` when the
controller onset opened it. `GET /api/zones/{n}/episodes` returns the stored episodes: the
last 20 per zone and kind, plus the last 8 onset heat-ups.

- A `heat` episode starts with the heating episode and continues after the target. It ends
  when `4060` stays within 0.2 C of the target for 30 minutes, or 2 hours after the crossing.
  It also ends on an open window, an overlay, away, a target change, a correction change
  (`offset changed`, see Early start), no report for `offline_after_sec`, 6 hours without
  reaching the target, or 1440 samples.
- On a zone the coordinator owns, a `heat` episode also starts when the controller demand
  leaves 0 during a `cool` episode while the block target is above the room temperature,
  whatever the rise. This onset episode starts at the last sample at 0 demand and carries
  `onset: true`. A heat-up the learner opens comes first, so one onset makes one episode. The
  daemon stores an onset episode only when `4060` rises at least 0.3 C above its first
  sample; else it drops the episode and logs one line. Onset episodes have 8 slots of their
  own: a new one evicts the oldest onset episode, never a heat-up of the learner. They stay
  out of the statistics history, which lists the heat-ups of the program.
- A `cool` episode covers a stretch of at least 30 minutes (at most 12 hours) with `40a0`
  at 0 and `4160` absent or 0. On an owned zone `4160` does not count: it is the demand of the
  other zones.
- An episode of either kind ends with `owner changed` when the zone owner changes. On an
  owned zone it ends with `source changed` when the controller changes its temperature
  source: the first external reading, or the reading removed.
- On an owned zone, an episode of either kind ends with `no zone report`, and none opens, while
  no member device has sent a frame for `offline_after_sec` (the demand moves no valve), or
  while the external reading is stale (`externalTemp.stale`: the controller reads the device
  sensor).
- `GET /api/zones/{n}/pid-suggestion` fits a first-order model with dead time and suggests
  `kp`, `ki` and `kd` with the SIMC rule. `confident` is true with at least 3 `heat`
  episodes used and R^2 of at least 0.8. The route writes nothing. Gains change only with
  `PATCH /api/install/zones/{n}`.
- The gains map to the daemon's controller step: a 60 s tick and a 600 s `Tref`. Nobody has
  measured the period and `Tref` of the valve's own controller on air, so `ki` and `kd` map
  exactly only on a zone the coordinator owns. On a device-owned zone `confident` is always
  false and `reason` is `valve controller period not verified`.
- The plant input of a heat-up is `40a0` on an episode the coordinator owned: `4160` is the
  circuit demand, the highest `40a0` of the circuit, and stays high while the valves of the
  zone are shut. On a device-owned episode it is `4160` when the zone reported it, else
  `40a0`. An episode stored without `owner` takes the current owner of the zone.
- A heat-up is skipped with `too few samples`, `no demand onset` (the input is above 0 on the
  first sample, or never), `driven by another zone` (`4160` input only), `no temperature rise`
  (`4060` never rises 0.1 C), `no fit` or `poor fit`. A cool-down whose `4060` spans 0.1 C or
  less is skipped with `no temperature change`: one step of the tag is no decay.

## Devices

### Faults, battery and alerts

`GET /api/health` lists `devices` with `lowBattery`, `fault` (with `faultWord` and
`faults`), `deviceWarnings`, `commsWarnings` and `offline`. `alerts` lists the devices with
at least one alarm. `/api/nodes` shows the same data as `LowBattery`, `Fault`, `FaultWord`,
`Faults`, `DeviceWarnings`, `CommsWarnings` and `Offline`.

- The fault word `01a3` holds flags and, in bits `0xf800`, one state code of the valve
  motor. The daemon decodes it into three lists of names, each `null` when it is empty.
  [`PROTOCOL.md`](PROTOCOL.md) gives the condition behind each name.
- `faults` names the device faults: the flags `storeWrite`, `configWrite` and `stackLow`,
  the valve states `calibrationNoEndStop`, `calibrationTravel`, `calibrationPower`, `stall`,
  `earlyStall`, `unknownResult`, `state12` and `state15`, and `unknown` for a bit with no
  known meaning. `fault` is true when `faults` holds a name, and only then does `alerts`
  carry `fault`.
- `deviceWarnings` names a valve state that is no fault: `notMounted` (the valve is off
  its radiator), `calibrationNoPinContact`, `shortTravel`, `lowVoltage` and `recalibrating`.
  It does not set `fault` and does not appear in `alerts`. The wall thermostat has no state
  code.
- `commsWarnings` names the two flags for the radio link: `noNeighbour` (`0x02`, no IPv6
  neighbour) and `noConfigAnswer` (`0x80`, no answer to the `d/config` GET for 90 minutes, or
  since start). They do not set `fault` and do not appear in `alerts`.
- `low_battery_cell_mv` is the threshold per cell: 2200 mV for a valve (two cells) and
  3300 mV for the wall thermostat (three cells). The level is the highest `0162` reading of
  the last three hours. `lowBattery` turns on below the threshold and off above the threshold
  plus 50 mV per cell. `BatteryPct` is linear per cell, 0 % at the threshold and 100 % at
  1500 mV.
- A device is `offline` after `offline_after_sec` without a frame.
- `bridgePresent` turns true when the daemon hears a data frame with its own coordinator
  source address. The daemon then stops to transmit for the rest of the run, and
  `transmitAllowed` is false. This is a last safeguard. It does not replace switching the
  commercial bridge off.
- `zoneFallback` lists the zones that the wall thermostat reports in fallback (`6460`). The
  modes are `hold`, `fixed` and `frost`. The daemon records the report and never sends a
  fallback mode.
- `timezone` in `GET /api/health` names where tag `02b2` comes from: `name`, `offsetMin`
  and `fallback`. `name` is `fixed offset` for a set `utc_offset_min`, the IANA name of
  `timezone`, or the name of the zone of the host. `fallback` is `true` for the zone of the
  host. A container without `TZ` runs in UTC, so the devices get an offset of 0. The daemon
  then logs `options.timezone is unset and the host zone is UTC` at start. Set `timezone`
  or `utc_offset_min` with `PATCH /api/install`, or start the daemon with `TZ` set. The
  field exists while the daemon holds an installation.
- `version` in `GET /api/health` is the version of the daemon: the release tag, or `dev`
  for a build without one.
- `GET /api/health` answers within three seconds. It answers `503` with `"ok": false` when
  the engine is busy (`"engine": "busy"`) or when the live radio loop ended (`radioError`).
  It reports `fsctrl0`, `calibrated` and `calibration` in live mode: see
  [Receiver calibration](#receiver-calibration). While the daemon waits after an import it answers
  `200` with `importWait` and no other state: see
  [State export and import](#state-export-and-import).
- `serialErrors` in `GET /api/health` is the number of serial replies that the link to the
  bridge lost since the daemon started. It exists in live mode. A reply that stops short is
  discarded and the daemon reads the next one, so the radio frame inside it is lost. The live
  radio loop ends only when one kind of exchange, the queue poll or the receive window, failed
  every time for 30 s. A count that keeps growing points to the USB link: see
  [Serial link faults](OPERATION.md#serial-link-faults).

### Receiver calibration

The live radio measures its frequency calibration (register FSCTRL0) from the frames it
receives, while the daemon runs. See [Radio calibration](OPERATION.md#radio-calibration).

- `fsctrl0` in `GET /api/health` is the register the receiver holds now, for example `0x34`.
  Without a stored calibration the receiver starts on `0x34`.
- `calibrated` is `true` when the register comes from a stored or a measured calibration.
- `calibration` holds `state`: `stored` (the register came from the database at start),
  `measuring` (the radio collects readings) or `measured` (the radio measured the register in
  this session). The daemon then stores a measured register and logs the result of the write.
  In `measuring` it also holds `readings`, the usable readings of the round in progress, and
  `want`, the readings one round needs (20): `{"state": "measuring", "readings": 7, "want": 20}`.
  A round whose correction is inside +-8 units ends the measurement on the current register;
  outside that band the radio moves the register and measures again, at most three rounds.
- `POST /api/radio/calibrate` deletes the stored calibration, sets the register back to `0x34`
  before the radio samples, and starts a new measurement from there. It answers `202` with the `calibration` object, which is
  `{"state": "measuring", "readings": 0, "want": 20}`. It answers `409` with `{"error": ...}` when
  the mode is not `live`. Under the Home Assistant add-on, ingress serves it without the token to
  an administrator only, like the export and the import of the state: see
  [State export and import](#state-export-and-import).

### Child lock, identify and calibration

- `POST /api/nodes/{id}/childlock` is for valves only. Another device kind gets `400`,
  because the wall thermostat has no `d/lock`. `ChildLock` in `/api/nodes` is `false` until
  the valve confirms a write, and `null` on a device that is not a valve.
- `POST /api/nodes/{id}/identify` makes a valve or the wall thermostat signal itself. The
  thermostat shows "Hi!" on its display. It needs a device that belongs to a zone.
- `POST /api/nodes/{id}/calibrate` starts the motor calibration of a valve. The daemon sends
  `PUT d/calibrate` and waits for the `2.xx` answer. A `2.xx` does not guarantee the stroke,
  because the valve drops the request in silence in some states. The result arrives in the
  `d/<serial>/mnt` report: `Telemetry` shows `calib_state` (1 started, 2 done, 3 failed),
  `calib_error`, `ctrl_1b5` and `ctrl_1b6`.
- No route detaches a device. A device leaves its network only when its button is held, which also
  wipes its storage. The reason is in
  [PROTOCOL.md](PROTOCOL.md#network-commands-and-leaving-the-network).

### Display

`GET /api/nodes/{id}/display` returns `orientation` (`horizontal` or `vertical`, tag `0149`)
and `notification` (tag `0158`, the notice of a remote change). `PUT` with
`{"orientation": "vertical"}`, `{"notification": false}` or both changes them. A missing
field stays as it is. The defaults are the captured values: horizontal, notice on
(`0158=0200`).

- The daemon writes the whole `d/config` under a new ETag `015a`. The valve answers `2.04`,
  rereads `d/config` and `z/N/config`, and homes its motor (a full stroke), as with the
  commercial bridge.
- With `"via": "dbg2"` the daemon writes only the changed records `0149` and `0158` in one
  `PUT d/dbg2/tlvs`. The valve does not reread and does not home. On the `2.04` the served
  document takes the new values under the ETag the valve knows. `"via": "config"` or no
  `via` selects the full write.
- `notification` changes only bits 9 and 10 of `0158`. A change that leaves the document
  unchanged writes nothing.
- The wall thermostat has no display settings and gets `400`.

### Node configuration

`POST /api/nodes/{id}/config` writes chosen tags of `d/config`: `tempUnitF`, `calibOffset`,
`traceEnable`, `lcdVariant`, `stateBits`, `etagHex`, `homeId`, `nodeTable`, `utcOffsetMin`
and `offlineScheduleEnabled`. A body with `reportIvlSec` gets `400`: the daemon never writes
tag `015d`.

`offlineScheduleEnabled` sets the value for one valve. It outranks `offline_schedule`.
`DELETE /api/nodes/{id}/config/offlineScheduleEnabled` removes it. The wall thermostat
accepts no value of its own.

### Interface module id

Tag `015d` of `d/config` is the interface module id of a device. Every valve gets 112.
The id of the wall thermostat selects the firmware image that the radio chip reflashes, so
freedo never invents it. The daemon learns the id from the `hvac/codes` report of the
thermostat or from a `d/config` document of the thermostat, and stores it.

- The daemon refuses 0, 112, `0x7fff` and every id that no known firmware family has. It
  learns the ids 202 and 1, 5, 6, 7, 9 with a warning, when another family reported before.
- At start the daemon drops a refused id from the database and continues. The thermostat has
  no id until it reports again.
- `/api/health` lists refused and dropped ids and warnings in `interfaceModuleIssues`, and
  the thermostats without an id in `interfaceModuleUnknown`.
- Until the id is known, the `d/config` GET of the thermostat gets `2.05` with the
  installation document without `015d`, and the daemon does not keep that document.
- `GET /api/boiler` reports the bus family in `BusType` and the id in `InterfaceModule`.

### Firmware state and transfer

- `GET /api/nodes/{id}/fw` queues a GET of `d/fw/state` for the next CSL contact. A `2.05`
  answer appears in `result` and, decoded, in `decoded`. The version is `major<<6 | minor`.
  The status nibble is: bit 0 pending, bit 1 image, bit 2 active, bit 3 confirmed. Valves and
  thermostat both report type 8, so the type does not tell the hardware.
- The daemon keeps the newest `d/fw/state` of each device with the durable desired state, with
  the time it arrived. A restart refills the node `Telemetry` fields (`fw_run_version`,
  `fw_build_hash`, the slot fields) from the stored body, so `GET /api/nodes` names the running
  firmware before the device reports again. The stored time is kept, so a transfer still
  refuses a report older than 5 minutes.
- A device PUTs `d/<serial>/fw/state` only at boot and on an image slot change, so after start
  the daemon reads `d/fw/state` once from each declared valve and wall thermostat that holds no
  stored report. The reads need an armed transmitter and automatic queueing, go one device at a
  time 30 s apart, and never repeat in a run. A failed read is not retried.
- `POST /api/nodes/{id}/fw` starts the transfer of an image to one device. The body needs
  `confirm: true`, `version` (M.m), `imageKind` and `image` in base64. The daemon refuses the
  request in dry-run, after it heard the commercial bridge on air, and when the last
  `d/fw/state` is older than 5 minutes.
- The daemon sends one block at a time (128 bytes, `POST d/fw` with Block1) and repeats a
  block up to 3 times. Other commands for the device stay queued meanwhile. After the last
  block it waits for the `PUT d/<serial>/fw/state` of the new image, answers `2.04`, reads
  `d/fw/state` and checks the confirmation. `GET` shows the progress under `transfer`.
  `DELETE` cancels it.
- The project does not distribute images. No transfer ran on air.

## Boiler

The wall thermostat sends each boiler resource as delta reports: a value comes again only when
it changes, or in a full report, which comes every 1.5 to 3.5 h on the captures. The daemon
stores the last raw value of each boiler tag once a minute and at shutdown, and a restart within
10 minutes restores the tags no report has set yet. A value that changed during the stop stays
at its stored value until the next change or the next full report. The energy estimate does not
count the stop.

### Hot water

`POST /api/boiler/dhw` sets a hot water temperature overlay with the same fields as
`POST /api/zones/{n}/setpoint` (`durationSec` included). It writes the wall thermostat. It
answers `503` while the installation has no hot water zone.

`GET /api/boiler` shows the hot water temperature as `DHWC` and the hot water setpoint as
`DHWSetpointC` (tag `045b` of `hvac/mon/dhw`). `DHWSetpointC` is the value that the wall
thermostat reports, in C. The daemon does not set it and it is not a target: the target of
the hot water zone is `declared[].target` in `GET /api/zones`. It is `null` until the
thermostat reports it, and while the boiler lists it as unsupported. One capture shows
53.00 C 19 s after a write of 53.00 C. No capture shows the value of a zone that follows a
program, so it is not verified that it follows the program.

### Boiler thermostat

The boiler thermostat is the wall thermostat wired to the boiler: the thermostat of the hot
water zone, or the heat source of the circuit with the lowest id while the installation has no
hot water zone. `GET /api/heatsource/capabilities` reads it, and `POST /api/boiler/flow`
writes it when the body has no `target`. Both answer `503` when the daemon finds no such
thermostat.

### Flow limit

The wall thermostat reads the flow limit (tag `2040`) from `h/<home>/c/<N>/config` and
applies it as the OpenTherm MaxTSet, in whole degrees, only when it opens the boiler
session again. Each application closes and opens the session.

- `flow_limit_c` has no default. A circuit gets `flow_limit_c` when it is set, unless
  `POST /api/boiler/flow` set a value, or a curve, the default curve or the adaptation manages
  the circuit. While `flow_limit_c` is unset, a circuit that nothing manages is served no
  `2040`. The thermostat then writes no MaxTSet. It caps its control setpoint at the upper
  bound of OpenTherm id 49 that the boiler reports, or at 70 C when that bound is not valid.
  Set `flow_limit_c` to a value that suits the boiler.
- A circuit with an enabled curve, or with the adaptation on, falls back to 48 C while
  `flow_limit_c` is unset. The fallback applies to a stale outdoor reading and to the start of
  the adaptation.
- The window is 30 to 75 C, and `POST /api/boiler/flow` accepts the whole window in whole
  degrees. The thermostat divides `2040` by 100 and drops the fraction. freedo serves
  the requested limit without a cut to a boiler bound. The thermostat writes it to the boiler
  as MaxTSet (OpenTherm id 57) with no clamp, and the boiler enforces its own maximum. Tag
  `0471` is the DHW setpoint upper bound, not a CH bound.
- The thermostat rereads `c/<N>/config` only after a `2.05` of `d/config`. For this the
  ETag of its `d/config` hashes the document and the served flow limits. A new limit
  changes the ETag and queues one empty `PUT d/config`. The thermostat rereads within a few
  seconds.
- `flow_curves` holds one weather curve per circuit: two points (outdoor temperature to
  flow limit), `min_c`, `max_c` and `enabled`. It is off by default. `POST /api/outdoor` with
  `{"tempC": n}` gives the outdoor temperature. A reading older than `outdoor_max_age_sec`
  returns the circuit to `flow_limit_c` (48 C while that option is unset).
- The served limit changes when the computed value, before rounding to whole degrees, is at least
  `flow_hysteresis_c` from the served one, and at most once per `flow_min_interval_sec`. This keeps a
  reading near a rounding boundary from moving the limit back and forth. The interval also starts at
  daemon start.
- A circuit with an active curve of its own refuses `POST /api/boiler/flow` with `409`. An `id` that the
  installation does not declare gets `400`.
- `GET /api/boiler` shows under `flowLimit` the outdoor temperature and its age, `defaultC`
  (`null` while `flow_limit_c` is unset) and, for each circuit, the computed and the served
  limit, the lowest and the highest limit it accepts (`minC`, `maxC`), the time of the last
  change and whether the thermostat read it. `servedC` is `null` while the circuit is served
  no limit.

`flow_default_curve` (default `false`) gives every circuit without an enabled curve of its own a
built-in weather curve, so that you do not define two points. The curve is a fit on the monthly
figures of one heating season on one plant with radiators and a condensing boiler. It is not the
algorithm of the tado cloud, which is not public.

- The curve is relative. The limit is `flow_limit_c` minus a reduction. The reduction is
  `3.2 + 0.33 x outdoor` (outdoor temperature in C), rounded to whole degrees and clamped to 0 to
  8 C. The limit never goes above `flow_limit_c` and never below 30 C.
- The line is the least-squares fit through seven monthly means, from 3 to 21 C outdoors. A monthly
  mean hides the daily swing, so the true curve can be steeper than the line. Below 3 C the line is
  an extrapolation. It gives a reduction of 0 from about -9.7 C down, so a cold day gets
  `flow_limit_c`. The cap of 8 C applies from about 14.5 C: the figures show 8 C at 19 to 21 C and
  8 to 9 C from 13.6 C.
- For `flow_limit_c` 56 C, the limit is 54 C at -5 C outdoors, 52 C at 3 C, 49 C at 10 C and 48 C
  at 16 C and above.
- The option needs `flow_limit_c`, the reference of the reduction. A `PATCH /api/install` that
  switches it on while `flow_limit_c` is unset gets `400`. Send both in one request, or set
  `flow_limit_c` first. A `null` `flow_limit_c` while the option is on gets `400` too.
- A circuit with an enabled curve of its own follows that curve. The default curve does not apply
  to it.
- The outdoor temperature comes from `POST /api/outdoor`. Home Assistant must feed it: the
  integration pushes the sensor that you select in its options. With no reading, or a reading older
  than `outdoor_max_age_sec`, the circuit returns to `flow_limit_c`, as with a curve of your own.
- The curve uses the same rules as the other curves: `flow_hysteresis_c`, `flow_min_interval_sec`,
  the cut to `maxC` and the single writer of tag `2040`. A new `flow_limit_c` reaches a circuit at
  its next allowed change.
- With `flow_auto_adapt` on, the curve value is the ceiling and the adaptation trims below it.
- `POST /api/boiler/flow` answers `409` for a circuit that follows the default curve. Switching the
  option off returns the circuit to `flow_limit_c`.
- Each item of `flowLimit.circuits` also shows `defaultCurve` (`true` while the circuit follows the
  default curve) and `reductionC` (the reduction in force now, `null` while the outdoor reading is
  missing or stale or the circuit does not follow the curve). `computedC` is the limit that results.
- The fit is checked against the monthly mean reduction that the tado cloud reports for the
  same plant (the monthly energy report, `flowTemperatureOptimization.reduction`) over one
  season, with monthly outdoor means of a weather archive: within 0.6 C from 3.6 to 19 C
  outdoors, except one month of 1.8 C at the start of the season, when the cloud started its
  adaptation again. At 8 C the live cloud value and the curve both serve the maximum minus 6 C.
  Below 3 C no month exists on either side. The cloud holds the warm-season limit at
  `max(48 C, maximum - 9)`; the cap of 8 C gives the same 48 C for a maximum of 56 C and
  one degree more for a higher maximum. No test on air covers the curve.

`flow_auto_adapt` (default `false`) switches on an automatic adaptation of the limit of each
circuit. It is a local controller. It is not the algorithm of the tado cloud, which is not
public.

- The served limit is `min(adapted, ceiling)`. The ceiling is the limit the daemon serves
  without adaptation: `flow_limit_c` (48 C while it is unset), or the value of the curve or of
  the default curve while the outdoor reading is fresh.
- The adapted limit starts at the served limit, or at the ceiling while the circuit is served
  none.
- It moves down by 2 C (minimum 40 C) when 12 hours passed since the last move, the circuit
  called for heat at least 2 hours in that time, and no room is behind.
- It moves up by 4 C (up to the ceiling) when a room with at least 90 % demand stays at least
  0.5 C under its target and gains less than 0.2 C in one hour of reports. A new rise needs
  another hour of reports.
- A zone report older than `offline_after_sec`, or a zone without a target, stops the descent.
  The controller reads only `4060`, `40a0` and the zone target. It does not use boiler values.
- The adapted limit survives a restart (`meta.flow_adapt`). The collected evidence restarts,
  so the first descent after a restart waits 12 hours again.
- With the adaptation on, `POST /api/boiler/flow` answers `409`. Switching it off returns the
  circuits without a curve to `flow_limit_c`, or to no limit while it is unset.
- Each item of `flowLimit.circuits` also shows `adapt`, `adaptedC`, `adaptedAt` and
  `adaptReason` (`start`, `satisfied`, `short`).
- The constants are design estimates. No test on air covers the adaptation.

### Energy and gas estimate

The daemon estimates the heat that the boiler delivers. Home Assistant holds the gas price.

- The estimate needs a boiler that reports its modulation over OpenTherm. A relay boiler has
  no estimate yet.
- The wall thermostat reports the relative modulation (`0452`) and the burner flag (`0457`) in
  `hvac/mon`. With the burner on, the power is
  `min + (max - min) x modulation / 100`. With the burner off it is 0.
- The estimate follows one thermostat: the heat source of the circuit with the lowest id.
  Without a circuit it follows the only thermostat that reported `hvac/mon`, and it follows
  none while several thermostats report. The samples of two boilers never mix. `reason` is
  `noReport` until that thermostat reports.
- `boiler_max_power_kw` and `boiler_min_power_kw` hold the output at 100 % and 0 % modulation.
  Without the maximum the estimate stays off.
- The thermostat sends only changed attributes. The daemon holds the two values until the
  next report. Each interval between two reports counts at the power of the first. An
  interval over 300 s adds no energy, because a longer silence with the burner on means a lost
  link or a stopped thermostat. `reason` is `stale` only in that case: with the burner off the
  thermostat reports seldom, and the counter runs at 0.
- The counter is in kWh and never decreases. It is stored in `meta.boiler_energy_kwh`, at
  most once per minute and at shutdown. Downtime adds no energy.
- The counter is a total. The thermostat does not report whether the burner heats rooms or
  hot water.
- The estimate has three error sources. The modulation is relative to the working range of
  the boiler and does not measure power. The efficiency is not modeled, so the counter is
  delivered heat and the burned gas is higher. The samples are sparse, so a short cycle is
  approximate.

`GET /api/boiler` reports it in `energy`: `running`, `reason` (`null` while running, else
`noMaxPower`, `noReport`, `stale`, `noBurnerFlag` or `noModulation`), `powerKW`, `totalKWh`,
`maxPowerKW`, `minPowerKW`, `holdSec` (300), `reportedAt`, `updatedAt` and `gas`.

The fuel counter in `energy.gas` counts the burned fuel in `fuel_unit` and needs no
efficiency. `fuel_unit` is `m3` (natural gas, the default), `l` (heating oil) or `kg` (LPG or
pellets). The `M3` in the names of the fields stays for every unit: `boiler_max_gas_m3h` and
`boiler_min_gas_m3h` hold the fuel flow at 100 % and at 0 % modulation with the burner on, in
`fuel_unit` per hour. `flowM3H`, `totalM3`, `maxFlowM3H` and `minFlowM3H` of `energy.gas` hold
flows and totals in the same unit, and `energy.gas.unit` names it. The daemon does not convert
a stored counter when `fuel_unit` changes. The data sheet of the boiler lists the flows. The
daemon has no default. The limit is 60 in each unit per hour, so a value in a smaller unit is
refused (500 kW burns about 53 m3/h of natural gas, 50 l/h of heating oil or 40 kg/h of
propane). The maximum is above 0 and the minimum is from 0 up to below the maximum. The count
needs both values and does not depend on the power values. It uses the same cycle, the same
300 s limit and the same sample order as the heat counter, and it is stored in
`meta.boiler_gas_m3`.

Example, not a default: a 24 kW condensing boiler on natural gas lists 2.63 and 0.30 m3/h, so
`{"boiler_max_gas_m3h": 2.63, "boiler_min_gas_m3h": 0.3}`.

It is not verified which maximum the relative modulation refers to (heating or hot water),
and the thermostat does not say which service the burner provides. If the hot water maximum
is higher than the heating maximum, a hot water draw can read up to about 15 % low.

`energy.gas` has `running`, `reason` (`noGasFlow` replaces `noMaxPower`), `flowM3H`,
`totalM3`, `maxFlowM3H`, `minFlowM3H` and `unit`. `GET /api/boiler` also shows the boiler counters
`BurnerStarts`, `BurnerHoursMin` and the group `Maintenance`. Each `hvac/codes` report replaces
the fault state:

- `Fault` is `true` when the report holds any fault entry, with or without an OEM code. It is `null` before the first report.
- `FaultCodes` lists the known OEM fault codes of the report, without duplicates, `[]` with none and `null` before the first
  report. A fault the boiler did not name has no code: `Fault` is `true` and `FaultCodes` is `[]`. A code is a number of
  the boiler maker. Code 0 is a valid maker code.
- `DiagnosticCode` is the OEM diagnostic code (OpenTherm id 115) of the report, `null` when the
  report holds none. A diagnostic code is no fault, also when it is 0.

A value that the boiler declares unsupported (tag `0481`) is `null` and listed in `Unsupported`.

### Gas meter

The user reads the gas meter now and then. The daemon records each reading in `fuel_unit`, the
unit of `energy.gas.totalM3`, and estimates the meter value between readings.

`POST /api/boiler/gas/meter` with `{"reading": 8785.957}` records one reading. `estimate` is the
fuel counter when the reading was taken, for a reading the user took a while ago: it is from 0 up
to the current counter, and it defaults to the counter the database holds. `at` is the RFC3339 time
the reading was taken, not in the future, stored for display only, and it defaults to now.
`replaced` is an optional boolean for a new meter: it drops every stored reading first and starts
the correction factor over, so the new meter may read below the old one.

`DELETE /api/boiler/gas/meter` removes the last reading, to undo a typo. It answers `404` while no
reading is stored.

The reading is finite, from 0 to 1e9, and never below the previous reading: a meter does not run
backwards. A lower reading is `400` and names the `replaced` flag. An estimate outside its range
and an `at` in the future are `400`. The route needs the fuel counter, so it answers `503` without
`boiler_max_gas_m3h` and `boiler_min_gas_m3h`, like the rest of `energy.gas`. The daemon keeps the
last 20 readings as JSON in `meta.boiler_gas_meter` and writes them on the call, not on the
counter's minute.

`GET /api/boiler` reports the meter in `energy.gas.meter`, `null` while no reading is stored:
`value`, the estimated meter value; `lastReading` and `lastReadingAt`; `readings`, the count kept;
`factor`; `factorReadings`; and `entries`, the stored readings oldest first, each with `at`,
`reading` and `estimate`.

The value is `lastReading + factor x (totalM3 - lastEstimate)`, rounded to 0.001. `totalM3` is
the raw fuel counter, so the value follows it between readings. The factor comes from the two most
recent readings whose estimate is at least one unit apart:
`factor = (reading2 - reading1) / (estimate2 - estimate1)`, accepted only from 0.5 to 2.0.
Outside that range, or without such a pair, the factor is 1. `factorReadings` is 2 when a factor
was learned, else 0.

The factor corrects the meter value only. `totalM3` and `flowM3H` stay the raw estimate, so
nothing that already reads them changes. The meter differs from the estimate for reasons the
estimate cannot see: other gas users on the same meter such as a hob, the efficiency the fuel
counter does not model, and the modulation the counter references.

## Statistics

The statistics are optional and off by default. While they are on, the daemon keeps a short
history of each zone and of the boiler, so the dashboard can draw the day of a room and the fuel of
each day without Home Assistant.

The rows live in their own SQLite file beside the state database: `freedo-state.db` gives
`freedo-state-history.db`. The [state export](#state-export-and-import) copies the state database
only, so a backup stays small and holds no history. The history file holds no network key. The
switch, the price and the currency live in the state database, so they survive a deleted history
and travel with a backup.

What the daemon records:

- Every 5 minutes on the wall clock, one sample per zone and one of the boiler. A heating zone
  records the room temperature of a zone report younger than `offline_after_sec` (the measuring
  device while the zone never reported), the target, on, the humidity of the measuring device or
  of the first member that reports one, the heating demand `40a0`, the open window and away. The hot
  water zone records the hot water temperature `DHWC`, the target and on. The boiler sample holds
  the flow temperature, the modulation, the burner flag, the heat and fuel counters, the burner
  start counter `BurnerStarts`, and the outdoor temperature of `POST /api/outdoor` while it is
  younger than `outdoor_max_age_sec`.
- The total of each local day, in the time zone of the programs: the fuel (the counter step times
  the [meter factor](#gas-meter) in force at that step), the fuel estimate (the raw counter step),
  the heat in kWh, the burner minutes (5 for each sample that found the burner on) and the burner
  starts (the counter step). A step across more than one hour without a sample adds nothing: the
  counters run while the statistics are off. A start counter that goes back, as after a boiler
  reset, adds nothing for that step.
- Per day also the count of samples, the mean outdoor temperature of the samples that had one,
  and the mean indoor temperature: per sample, the mean of the heating zones with a temperature.
  The consumption advisor compares days with these, because a colder day burns more fuel with
  the same program.
- The summary of each finished heat-up episode (see
  [Plant episodes](#plant-episodes-and-controller-suggestion)): start, end, start temperature,
  target, crossing, dead time, overshoot, settling time and end reason.

Samples and episodes stay 90 days. Daily totals stay 13 calendar months: the current month and the
12 before it. The daemon drops older rows when the local day changes.

`GET /api/history` answers `available` (false without a state database), `enabled`, `error` (why
an enabled history has no file, else `null`), `since` (the oldest sample, RFC3339, or `null`),
`sizeBytes`, `intervalSec` (300), `sampleDays` (90), `dayMonths` (13), `fuelPrice` (`null` while
unset), `currency` (`EUR` by default) and `comfortMaxC`, the comfort target above which the
consumption advisor suggests a degree less (21 by default).

`PUT /api/history` takes any of `enabled`, `delete`, `fuelPrice`, `currency` and `comfortMaxC`, and
answers the same view. `comfortMaxC` is from 16 to 25, or `null` for the default. `delete: true`
removes the history file and needs `enabled: false` in the same body or already stored: on is `400`.
`fuelPrice` is the price of one `fuel_unit`, from 0 to 1000, or `null` to remove it. `currency` is
an ISO 4217 code of three capital letters. Without a state database the route is `409`.

`GET /api/history/zones/{number}?date=YYYY-MM-DD` returns one local day of a zone, today by default:
`zone`, `date`, `from` and `to` (the bounds of the day, RFC3339), `intervalSec`, `first` (the local
date of the oldest sample of the zone, or `null`), `samples` and `episodes`. A sample has `atMs`,
`tempC`, `targetC`, `on`, `humidityPct`, `demandPct`, `window`, `away` and `outdoorC`, the
outdoor temperature of the boiler sample of the same time; a field with no value is `null`. An
episode has `startedMs`, `endedMs`, `startC`, `targetC`, `crossedMs`, `deadTimeSec`,
`overshootC`, `settlingSec` and `endReason`.

`GET /api/history/energy?from=YYYY-MM-DD&to=YYYY-MM-DD` returns the days from `from` to `to`, both
included, by default the 13 months kept: `from`, `to`, `unit` (`fuel_unit`), `fuelPrice`,
`currency` and `days`. A day has `day`, `fuel`, `fuelEstimate`, `heatKWh`, `burnerMin`,
`burnerStarts` (`null` without the counter), `outdoorC` and `indoorC` (the means, `null` without a
value), and `coverage`, the share of the 5-minute slots of the local day that have a sample. A
sample without the start counter keeps the last one known for up to an hour. A day that began before these fields existed (statistics schema 1) has them all `null`. A day with no sample has no row.

`GET /api/history/advice?days=7|28|90` (28 by default) answers `days`, `from`, `to`, `unit`,
`fuelPrice`, `currency`, `split`, `model` and `advice`. `split` covers the local days from `days` - 1 days
ago to today. `model` always covers the last 90 days, so a short window still gets it. The route
writes nothing, and it keeps the model 15 minutes.

- `split` is where the fuel went: `fuel` (the total of the days, with the meter factor),
  `heating`, `hotWater` and `unattributed`, and `zones`, one row per heating zone with `zone`,
  `fuel`, `share` of the heating fuel and `fuelPerDegreeHour`. Each 5-minute step takes the zone
  state of its first sample. A step goes to heating when a heating zone has a demand, split between
  those zones in proportion to the demand. With `radiator_w` on every heating zone the demand is
  weighted by it and `weighted` is `true`; with one zone missing it, every zone weighs the same. A
  step without demand goes to hot water when the burner is on and every heating zone reported its
  demand. The rest is unattributed: a zone without a fresh report may have been heating. The parts
  follow the samples and are scaled to `fuel`, so a zone carries the mean meter factor of the
  window. The split is an estimate: no meter measures a room.
- `model` fits the heating fuel of each day on its degree-hours, (indoor mean - outdoor mean) x
  the hours sampled: `fuelPerDegreeHour`, its standard error `fuelPerDegreeHourErr`,
  `fuelPerDayOffset` (internal and solar gains, usually negative) and `r2`. A day counts with 90 %
  of its slots sampled, 90 % with an outdoor temperature, and some fuel for heating. `usable` needs
  14 such days, degree-hours that span at least 30 % of their mean, a positive slope and an R^2
  of 0.6; else `reason` says what is missing. A zone's `fuelPerDegreeHour` is the house slope times
  its share of the heating fuel over its share of the degree-hours, both over the 90 days and over
  the steps where the zone had a temperature. It is `null` while the model is not usable or the
  zone has no temperature.

- `advice` lists the suggestions of the window, highest fuel first, then those without a figure.
  Each has `id`, `kind`, `zones`, `hours` (how long the rule matched; for `window` and `away`, the
  hours the zone heated with the flag set), `fuel` and `cost` (each
  `{value, low, high}` or `null`), `confidence` (`high`, `medium` or `low`) and `evidence`. `fuel`
  is the fuel spent for `window`, `vent` and `away`, with the +-25 % error of the split, and the
  fuel the change would have saved over the window for `setpoint` and `setback`, with two standard
  errors of the slope and the error of the split. `cost` is `fuel` times `fuelPrice`, `null`
  without a price. A space that got no heating fuel in the window gets no suggestion: a room
  heated by its neighbours never asks. Zones with the same `shared_space` form one space, so one
  `setpoint` or `setback` covers all of them.

  | `kind` | Matches | `evidence` |
  |---|---|---|
  | `window` | a zone heated for 15 minutes or more while its window flag was set | none |
  | `away` | a zone heated for 15 minutes or more while away | none |
  | `vent` | 2 h or more of demand of 60 % or more, without the window flag, in which the room rises less than 1 C while the humidity falls 3 points or more, at 0.75 points an hour or faster, with fuel attributed to the zone: an open window that no sensor reports, such as a tilted sash. Confidence `medium` | `periods`, the last 5, each `startMs`, `endMs`, `riseC`, `humidityDropPct` |
  | `setpoint` | a space above `comfortMaxC` for 1 h or more, on a quarter of the days of the window or more: a boost on a single day is no habit. The saving is one degree less over the hours the space held its target within 0.5 C | `targetC`, `thresholdC`, `fromMin` and `toMin`, the minutes of the day of the longest block found on half of the days or more, else of the most frequent 5 minutes. `toMin` is exclusive, up to 1440, and less than `fromMin` for a block across midnight |
  | `setback` | nights, 23:00 to 06:00, at least 6 h above the proposed target: comfort - 2, but never under 18 C, because a colder bedroom is no comfort. The comfort target of the space is the median of its daily highest targets, so one boost does not move it. The saving assumes the room reaches half of the extra depth on average, 30 to 70 % for the range | `comfortC`, `setbackC` (the median night target, equal to `comfortC` when the nights do not drop), `proposedC`, `hoursPerDay` |
  | `unreachable` | a zone that stays more than 0.5 C under its target with demand of 90 % or more, for an hour a day or more. No figure: the radiator, the valve or the flow temperature falls short | `gapC`, the mean shortfall |
  | `short_cycle` | days with more than 6 burner starts per hour of burning, over 30 burner minutes or more. No figure | `days`, `startsPerBurnerHour`, the worst day |

  `setpoint` and `setback` come only with a `fuel` figure, with confidence `medium`. There is none
  while the model is not usable, when the space has no fuel per degree-hour (no temperature, or no
  heating fuel in the 90 days), or when it never held its target within 0.5 C over the matched
  hours: a change without a saving to show is no suggestion.

The four read routes answer `409` while the statistics are off, `400` for a date that is not
`YYYY-MM-DD`, a `from` after `to` or `days` other than 7, 28 and 90, and `404` for a zone that is
not declared.

## Pairing

`POST /api/pair/window` with `{"seconds": 120}` opens the pair window. The maximum is 600.
`{"seconds": 0}` closes it. `GET /api/pair/window` shows `open`, `opened`, `until`,
`responder` and `joiners`. `POST /api/pair` with `{}` pairs the single device in `joiners`. With several
devices, or without an open window, pass `{"target": "<short>"}`. A target outside the
installation must appear in `joiners`. `networkKeyHex` replaces the network key of the
installation for this call.

A device declared without a serial gets it from its first own `d/<serial>/...` request. The
daemon writes the serial into the installation when the prefix fits the kind (`VA` for a
valve, `RU` for a wall thermostat) and no other device holds it. A declared serial never
changes this way.

`POST /api/install/devices` needs the `eui` of the device and answers `400` without it. A new
device shows its EUI in `joiners`, so open the window before you declare the device.

The full procedure is in [OPERATION.md](OPERATION.md#pairing-a-device). It ran on air on one valve,
through the API. A network with no paired device and a wall thermostat are not verified on air.

## State export and import

The two routes move the whole state of a daemon to another daemon, or back to an earlier state. The
state is the installation with the network key and the coordinator identity, the programs and the
presets, the frame counters, the device sessions, the options and the learned values. Both routes
need the API token: the file holds the network key, and an import replaces the identity of the
network.

Under the Home Assistant add-on there is a second way in, for administrators. A request from the
ingress gateway `172.30.32.2` passes without the token when its header `X-Remote-User-Id` names an
active Home Assistant administrator. The daemon asks Home Assistant at every request. The answers
without the token:

| Case | Answer |
|---|---|
| The user is an active administrator. | The route runs. |
| No `X-Remote-User-Id`, an id that Home Assistant does not know, a user who is not an administrator, an inactive user, a system user. | `403` |
| Home Assistant does not answer in 5 seconds, or its answer is not usable. | `503` |
| The request comes from another address, with or without the header. | `401` |

The two pairs, with `POST /api/radio/calibrate`, are in `internal/daemon/ingress_admin_routes.json`. See
[SECURITY.md](../SECURITY.md#backup-home-assistant-administrators-only).

`GET /api/state/export` answers with one SQLite file. The daemon first saves its state, then writes
the file with `VACUUM INTO`, which reads one consistent snapshot while the daemon keeps running. The
file is the database itself, with no `-wal` file. Two more rows of the table `meta` say where it
comes from: `exported_by` is the daemon version and `exported_at` is the time, RFC 3339 in UTC. The
schema version is the row `schema_version` that every database holds. The answer has
`Content-Type: application/vnd.sqlite3`, `Cache-Control: no-store` and the file name
`freedo-state-<version>-<UTC time>.db` in `Content-Disposition`. Keep the file private.

```sh
curl -H "Authorization: Bearer $(cat freedo_api_token)" -OJ http://127.0.0.1:8080/api/state/export
```

`POST /api/state/import?confirm=true` takes the file as the request body. Without `confirm=true`
the daemon answers `400` and reads nothing. The daemon checks the file before it touches its own
database:

| Check | Answer when it fails |
|---|---|
| The body is at most 64 MiB. | `413` |
| The file is a SQLite database with the freedo schema. | `400` |
| The schema version is not newer than this daemon reads. | `409`: update the daemon first |
| `PRAGMA integrity_check` finds no damage. | `400` |
| The installation loads and validates, as at a start. | `400` |

A file of an older schema is accepted: the daemon migrates the copy before it uses it. A refused
import changes nothing.

An accepted import answers `202`:

```json
{"schema": "8", "exportedBy": "0.7.1", "exportedAt": "2026-03-01T10:00:00Z", "restart": true, "waitSec": 0}
```

The daemon stores the checked file as `<database>.import` next to its database and restarts
itself: it stops in order, as on SIGTERM, and replaces its process with a new start of the same
command line. The process id stays, so a container, a service manager or the add-on start script
sees one process that keeps running. The new start moves the current database and its `-wal` and
`-shm` files to `backup/before-import-<UTC time>/` next to the database, keeps the three newest of
these folders, and moves the imported file into place. A daemon that stops between these steps
finishes them at its next start. The API does not answer for a few seconds.

`waitSec` is `250` when the daemon transmits on a live radio, else `0`. A device keeps the CoAP
message identifiers that it saw for 247 seconds, and the imported database continues its own
sequence of identifiers. So a start with `--tx` on a live radio waits until 250 seconds have passed
since the import, before it opens the radio. The devices keep their programs during
that time. A dry-run start does not wait. The time counts from the import, so a restart in the wait
does not shorten it.

During the wait the daemon listens on its address with the same token and ingress rules, and holds
no engine:

- The files of the dashboard load.
- `GET /api/health` answers `200` with `importWait`. `leftSec` is the wait that is left, in whole
  seconds, rounded up. The answer carries no state of the devices:

  ```json
  {"ok": true, "mode": "live", "tx": true, "txArmed": false, "transmitAllowed": false, "importWait": {"leftSec": 227}}
  ```

- Every other route under `/api` answers `503` with the reason in `error` and the seconds that are
  left in the `Retry-After` header. No request changes the state or queues a message. The export
  and the import are refused too: the daemon does not serve its database before it starts.

At the end of the wait the daemon closes this listener and starts as usual in the same process.
The API does not answer for the moment in which the radio opens. The devices do not check the frame counter, so a lower
counter in the imported database is accepted.

```sh
curl -H "Authorization: Bearer $(cat freedo_api_token)" -H "Content-Type: application/octet-stream" \
  --data-binary @freedo-state-0.7.1-20260301T100000Z.db \
  "http://127.0.0.1:8080/api/state/import?confirm=true"
```

The imported state does not tell the devices that their documents changed: check the programs
after an import, as after a [database rollback](OPERATION.md#schema-upgrade-and-rollback). An
import of a database with another network key cuts the devices off until they are paired again.

## Unhandled log

The daemon appends one line to `unhandled_log` for each radio event it does not fully
handle. A line has six tab-separated columns: time, frame class, source, destination, reason
and frame. `GET /api/unhandled` returns the counts by reason.

- The frame column holds the bytes on air in hexadecimal. The network key encrypts them and
  stays in the database. A data frame that opens with the public pairing key shows only the
  16 header bytes, because the `d/pair` command carries the network key.
- The reason of an authentication request lists the payload tags. A secret tag shows only its
  length: `0007` (device token), `0260` (serial), `025e` (session id), `0261` and `0262`
  (challenge keys).
- The log still holds device labels or serial numbers, the clear header of each frame (source
  and destination EUI, sequence number), the CoAP path of a request (which can hold the serial
  and the home id) and the value of non-secret tags.

Remove or replace serial numbers and the home id before you attach the log to a report. The
file only grows. Rotate or delete it from time to time.
