CappyT/freedo/addon/DOCS.md

# freedo

freedo is a local coordinator for tado 868 MHz heating devices. This add-on runs the freedo
daemon. Home Assistant calls an add-on an "app" in recent releases.

The project is experimental. Read [Status](https://github.com/CappyT/freedo#status) and
[Scope and limits](https://github.com/CappyT/freedo#scope-and-limits) in the project README
before you use it.

## Requirements

- An ESP32 with a CC1101 radio, flashed with the bridge firmware of the freedo project, on a USB
  port of the Home Assistant host.
- One coordinator on the radio network. Switch the commercial tado bridge off before you turn on
  Transmit.

## Installation

1. Open the add-on store, then the menu, then Repositories. Enter
   `https://github.com/CappyT/freedo`.
2. Install freedo and open its Configuration tab.
3. Select the serial port of the radio bridge and save.
4. Start the add-on. Leave Protection mode on.
5. Install the freedo integration. HACS installs it from the same repository. Home Assistant then
   lists freedo as discovered: select it and confirm.

## Options

| Option | Default | Meaning |
|---|---|---|
| `serial_port` | empty | The serial port of the radio bridge. Empty means no radio: the daemon only serves its API. |
| `api_token` | empty | The bearer token of the API. Empty means the add-on creates one on the first start. |
| `transmit` | off | Send frames on air. Off is dry-run: the daemon listens and decides, and sends nothing. |

The add-on starts in dry-run. Turn Transmit on only after the
[first radio session](https://github.com/CappyT/freedo/blob/main/docs/OPERATION.md#first-radio-session)
checks.

## Pre-releases and the beta add-on

This add-on runs stable releases only. Pre-releases run in a second add-on of the same repository,
freedo beta, which has its own data folder. Its documentation describes the move there and the return
to this add-on, with a [backup](#backup).

The two add-ons must not run at the same time: one coordinator serves a radio network. Each add-on
writes its host name to `/share/freedo/owner.json` at start and the time of its stop when it stops. An
add-on that finds the other one in that file asks its API port. When the other add-on answers, the
start stops with an error in the log. When Transmit is on and the other add-on stopped less than 250
seconds before, the start waits for the rest of that time. A device keeps the message identifiers it
saw for 247 seconds, and each add-on continues its own sequence of identifiers. Turn on Start on boot
for one of the two add-ons only.

The daemon also opens the serial port for itself alone. A second daemon on the same port stops at
start with `Serial port busy`.

## Backup

The page Settings of the [web interface](#web-interface) has the section Backup.

- Download backup saves one file with the whole state of the daemon: the rooms, the devices, the
  heating circuits, the programs, the network key, the frame counters and the learned values.
- Restore backup takes such a file. The daemon checks the file, keeps its current database in
  `/data/backup/before-import-<time>/` (the three newest of these folders stay) and restarts on the
  file by itself. The add-on does not stop. The page loses the daemon for a few seconds and
  reconnects.

The backup is how the state moves between this add-on and freedo beta, in both directions. Nothing
moves by itself: the add-on writes no copy of its state at start or at stop.

Both actions are for Home Assistant administrators. In the web interface an administrator needs no
token. Every other user reads in the section that only a Home Assistant administrator can download or
restore a backup. The add-on asks Home Assistant about the user at every request: an administrator is
an active user who is the owner or is in the group of the administrators. When Home Assistant does not
answer, the add-on refuses. A client of the port 18080 needs the API token, as for every route.

For that question the add-on has the permission `homeassistant_api`. With it the add-on can call the
whole API of Home Assistant as an administrator. freedo uses one call, the list of the users, and only when someone
asks for a backup. The security rating of the add-on does not change.

The backup holds the network key. Anyone who has the file can read the radio traffic and command the
devices. Keep it private and delete it when you do not need it.

With Transmit on, the daemon waits 250 seconds after a restore before it starts. During that time the
web interface shows the seconds that are left and takes no command, and the entities of the integration
are unavailable. A restart of the add-on does not shorten the wait: the time counts from the restore.
A device keeps the message identifiers it saw for 247 seconds, and
the restored state continues its own sequence of identifiers. The devices keep their programs while
the daemon waits. Check the programs after a restore: a device keeps the program it fetched last until
a schedule write changes its document.

A file from a newer daemon is refused: update this add-on first. A file from an older daemon is
upgraded.

### The folder /share/freedo/stable of older releases

Releases up to 0.7.0 copied the database to `/share/freedo/stable/` at every start and stop. This
release does not write or read that folder, and it does not delete it. The copy holds the network key,
and every add-on that maps the `share` folder can read it. Delete `/share/freedo/stable` by hand, for
example with a file editor add-on or a terminal. The log names the folder at every start while it
exists.

## Web interface

The add-on has a web interface for the zones, the hot water, the boiler and the devices. Select Open
Web UI on the add-on page, or the entry freedo in the sidebar. The page asks for no token: Home
Assistant has already signed you in, and the add-on accepts the calls of the page from the Home
Assistant gateway.

Every Home Assistant user can open the page, also a user who is not an administrator. The sidebar entry
shows for administrators only, but the page opens for everyone who signs in. Without the token, a user
can read the state of the plant, set temperatures and weekly schedules, switch zones off, switch the home
between home and away, set the flow limit, set the options and the temperature offset of a room, rename a
device, lock a valve, and identify or restart a valve or the wall
thermostat. The same user can change the installation and pair a device: add, change and delete rooms and
heating circuits, add, move and remove devices, set the time zone, open the pair window and send the pair
command. The page needs this for the first setup, because the add-on keeps a token that it creates in its
data folder. The identity of the network, the network key, a pairing with another key,
calibration of a valve, firmware, raw device reads and the debug routes need the token, also from the
page. The [backup](#backup) and the new measurement of the radio calibration are for Home Assistant
administrators only.
Give the right to open the page with care.

The port 18080 does not share this rule: a client of that port needs the token for every API route. The
page is also at `http://<host>:18080/` when the Network tab publishes the port. It then asks for the
token once. See [Dashboard](https://github.com/CappyT/freedo/blob/main/docs/OPERATION.md#dashboard) and
[Security](https://github.com/CappyT/freedo/blob/main/SECURITY.md#home-assistant-ingress).

## API and token

The HTTP API listens on port 18080. The Network tab changes the host port. Clear the host port to
keep the API inside Home Assistant: the integration reaches the add-on by its host name and does
not need the host port. Every API request needs `Authorization: Bearer <token>`. The only exceptions
are the calls of the [web interface](#web-interface) through Home Assistant, which are listed there.

With an empty `api_token`, the add-on creates a random token on the first start and keeps it in its
data folder. The add-on gives that token to Home Assistant through discovery, so the integration
needs no address and no token. To call the API from another client, set `api_token` to a value you
choose.

## Installation data and network key

The add-on has no option for the network key, the devices or the zones. They live in the daemon
database. On the first start, the daemon creates a network key and a coordinator identity. You
manage the installation through the API under `/api/install`. The
[API reference](https://github.com/CappyT/freedo/blob/main/docs/API.md) describes it.

## Data and backups

The add-on keeps its state under its data folder: the database `freedo-state.db`, the generated
`api_token` and the log `freedo-unhandled.log`. Home Assistant backups include this folder. The
database holds the network key, so protect the backups. The folder `backup` holds the databases that
a [restore](#backup) replaced, with their network keys. The only data outside the data folder is
`/share/freedo/owner.json`, the record of the add-on that runs: it holds a host name and a time.

The backup is cold: Home Assistant stops the add-on, copies the folder and starts the add-on again.
A cold backup keeps the SQLite files consistent.

The log `freedo-unhandled.log` grows without a limit. Delete it from time to time. It can hold
device labels and serial numbers: remove them before you share it.

## Behavior

- The add-on logs to the add-on log.
- Stop and restart send SIGTERM. The daemon saves its state and exits in less than 10 seconds. The
  Supervisor waits 30 seconds.
- After a radio error the daemon exits. Turn on the Watchdog switch of the add-on so that Home
  Assistant starts it again.
- The daemon follows the time zone of its container (variable `TZ`) for the device clock and the
  program times. The Supervisor sets `TZ` from the Home Assistant time zone. The add-on has no
  time zone option. Check that `timezone.fallback` in `GET /api/health` is `false`. If it is
  `true`, the daemon logs a warning at start. Set the zone with `PATCH /api/install` and
  `{"timezone": "<IANA name>"}`, for example `Europe/Rome`. The
  [operation guide](https://github.com/CappyT/freedo/blob/main/docs/OPERATION.md#time-zone) has the
  command.

## Support

Report issues at https://github.com/CappyT/freedo/issues.
