CappyT/freedo/assets/brand/social-preview.png

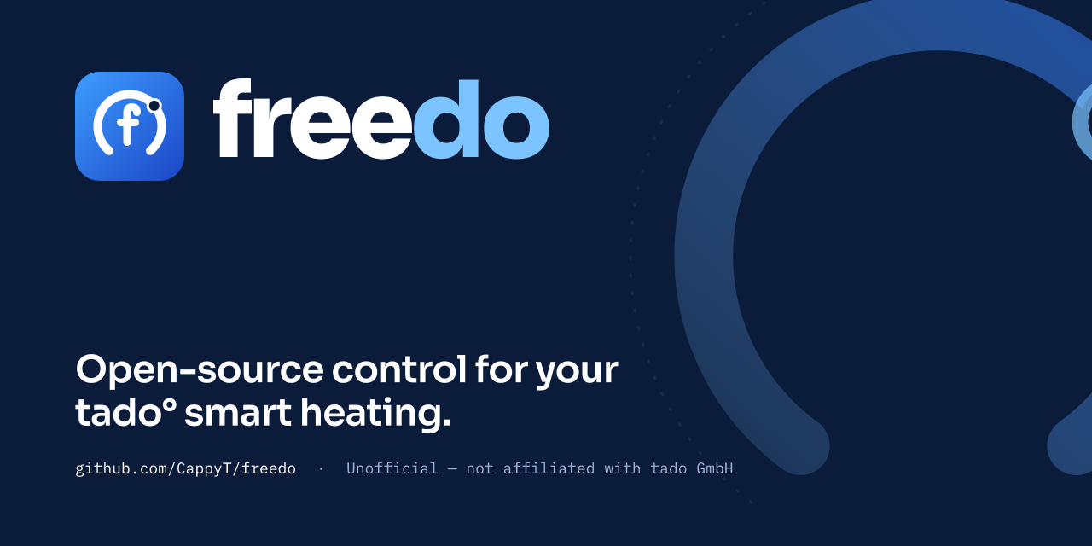
assets/brand/social-preview.png
