CappyT/freedo/tado/testdata/frames_frag_uplink.txt

69ec3009a1cefa07c51b0008a4defa07f1e6c0810770f88ecb8a533b1fb3d7b79aaa1a47dff649cff15693328024e6d841d85ccac4dea7ed462f3f52f9bb98ceaaf56739290efff33fff69dbbd84ff53061f49b7423b35a51bc97da59fab843b3fb18071d4fb25187c27b0154d09ca91e1dc7d50f6249ccbe57924
69ec3109a1cefa07c51b0008a4defa0740db25f4fd06e6c232a530de8fe9165461fef7900ab9dbcac443f0b05627e1adaf93ad6c70d386369cb540bfe5faceae026cfdaaf54c77694272f82467cfedd89ef947d4dd29dd885ca024228cf6b650647ca596
