CappyT/freedo/hardware/radio/freedo-radio.kicad_pcb

## KiCad design hardware/radio/freedo-radio.kicad_pcb (2026-09-25)

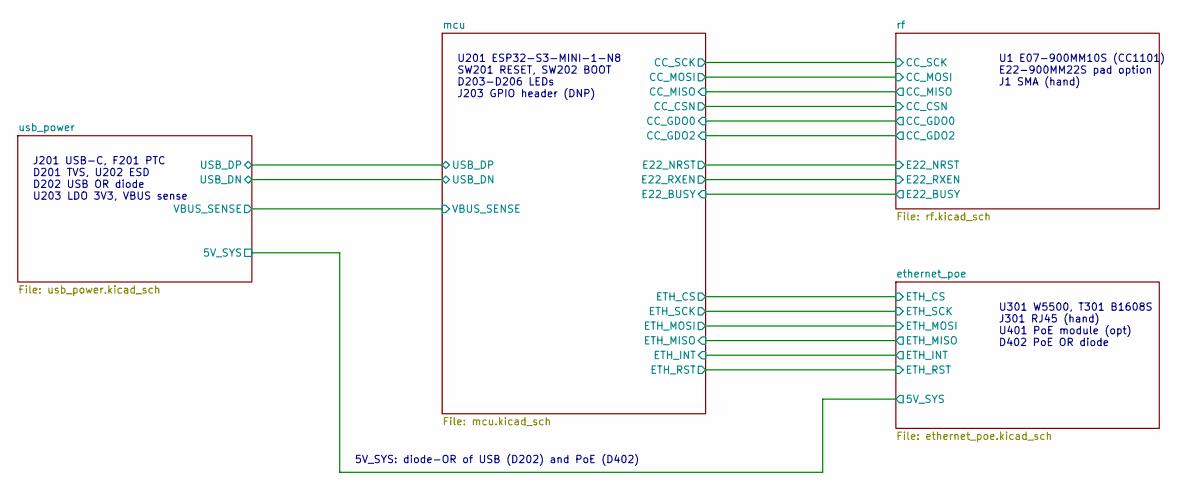
[picture p5: schematic freedo-radio.kicad_sch, freedo radio rev A]

Notes on the sheet:
J201 USB-C, F201 PTC D201 TVS, U202 ESD D202 USB OR diode U203 LDO 3V3, VBUS sense
U201 ESP32-S3-MINI-1-N8 SW201 RESET, SW202 BOOT D203-D206 LEDs J203 GPIO header (DNP)
U1 E07-900MM10S (CC1101) E22-900MM22S pad option J1 SMA (hand)
U301 W5500, T301 B1608S J301 RJ45 (hand) U401 PoE module (opt) D402 PoE OR diode
5V_SYS: diode-OR of USB (D202) and PoE (D402)

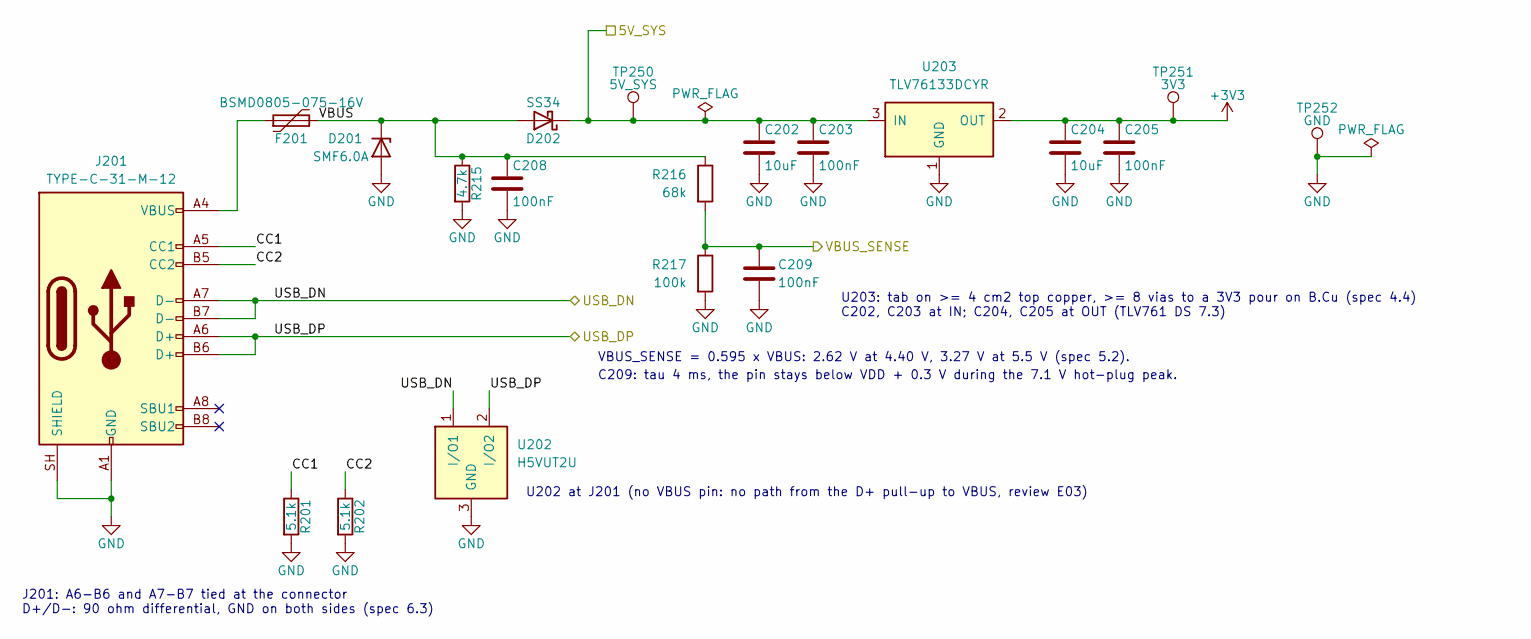
[picture p6: schematic usb_power.kicad_sch, freedo radio rev A: USB and power]

Parts:
C202: 10uF; C_0805_2012Metric; MPN CL21A106KAYNNNE; LCSC C15850
C203, C205, C208, C209: 100nF; C_0603_1608Metric; MPN CC0603KRX7R9BB104; LCSC C14663
C204: 10uF; C_0603_1608Metric; MPN CL10A106KP8NNNC; LCSC C19702
D201: SMF6.0A; SOD-123FL_L2.7-W1.8-LS3.8-RD; MPN SMF6.0A; LCSC C19077499
D202: SS34; SMA_L4.3-W2.6-LS5.2-RD; MPN SS34; LCSC C8678
F201: BSMD0805-075-16V; F0805; MPN BSMD0805-075-16V; LCSC C976303
J201: TYPE-C-31-M-12; HRO_TYPE-C-31-M-12; MPN TYPE-C-31-M-12; LCSC C165948
R201, R202: 5.1k; R_0603_1608Metric; MPN 0603WAF5101T5E; LCSC C23186
R215: 4.7k; R_0603_1608Metric; MPN 0603WAF4701T5E; LCSC C23162
R216: 68k; R_0603_1608Metric; MPN 0603WAF6802T5E; LCSC C23231
R217: 100k; R_0603_1608Metric; MPN 0603WAF1003T5E; LCSC C25803
TP250: 5V_SYS; TestPoint_Pad_D1.5mm
TP251: 3V3; TestPoint_Pad_D1.5mm
TP252: GND; TestPoint_Pad_D1.5mm
U202: H5VUT2U; SOT-23-3_L2.9-W1.5-P1.90-LS2.6-BR; MPN H5VUT2U; LCSC C20615824
U203: TLV76133DCYR; SOT-223-4_L6.5-W3.5-P2.30-LS7.0-BR; MPN TLV76133DCYR; LCSC C7527500

Connections:
+3V3: C204.1, C205.1, TP251.1, U203.2 (OUT), U203.4 (OUT); also elsewhere on the board
/ethernet_poe/5V_SYS: C202.1, C203.1, D202.1 (K), TP250.1, U203.3 (IN); also elsewhere on the board
/mcu/VBUS_SENSE: C209.1, R216.2, R217.1; also elsewhere on the board
/usb_power/CC1: J201.A5 (CC1), R201.1
/usb_power/CC2: J201.B5 (CC2), R202.1
/usb_power/USB_DN: J201.A7 (D-), J201.B7 (D-), U202.1 (I/O1); also elsewhere on the board
/usb_power/USB_DP: J201.A6 (D+), J201.B6 (D+), U202.2 (I/O2); also elsewhere on the board
/usb_power/VBUS: C208.1, D201.1 (K), D202.2 (A), F201.2, R215.1, R216.1
GND: C202.2, C203.2, C204.2, C205.2, C208.2, C209.2, D201.2 (A), J201.A1 (GND), J201.A12 (GND), J201.B1 (GND), J201.B12 (GND), J201.SH (SHIELD), R201.2, R202.2, R215.2, R217.2, TP252.1, U202.3 (GND), U203.1 (GND); also elsewhere on the board
unnamed: F201.1, J201.A4 (VBUS), J201.A9 (VBUS), J201.B4 (VBUS), J201.B9 (VBUS)

Notes on the sheet:
U203: tab on >= 4 cm2 top copper, >= 8 vias to a 3V3 pour on B.Cu (spec 4.4) C202, C203 at IN; C204, C205 at OUT (TLV761 DS 7.3)
J201: A6-B6 and A7-B7 tied at the connector D+/D-: 90 ohm differential, GND on both sides (spec 6.3)
U202 at J201 (no VBUS pin: no path from the D+ pull-up to VBUS, review E03)
VBUS_SENSE = 0.595 x VBUS: 2.62 V at 4.40 V, 3.27 V at 5.5 V (spec 5.2).
C209: tau 4 ms, the pin stays below VDD + 0.3 V during the 7.1 V hot-plug peak.

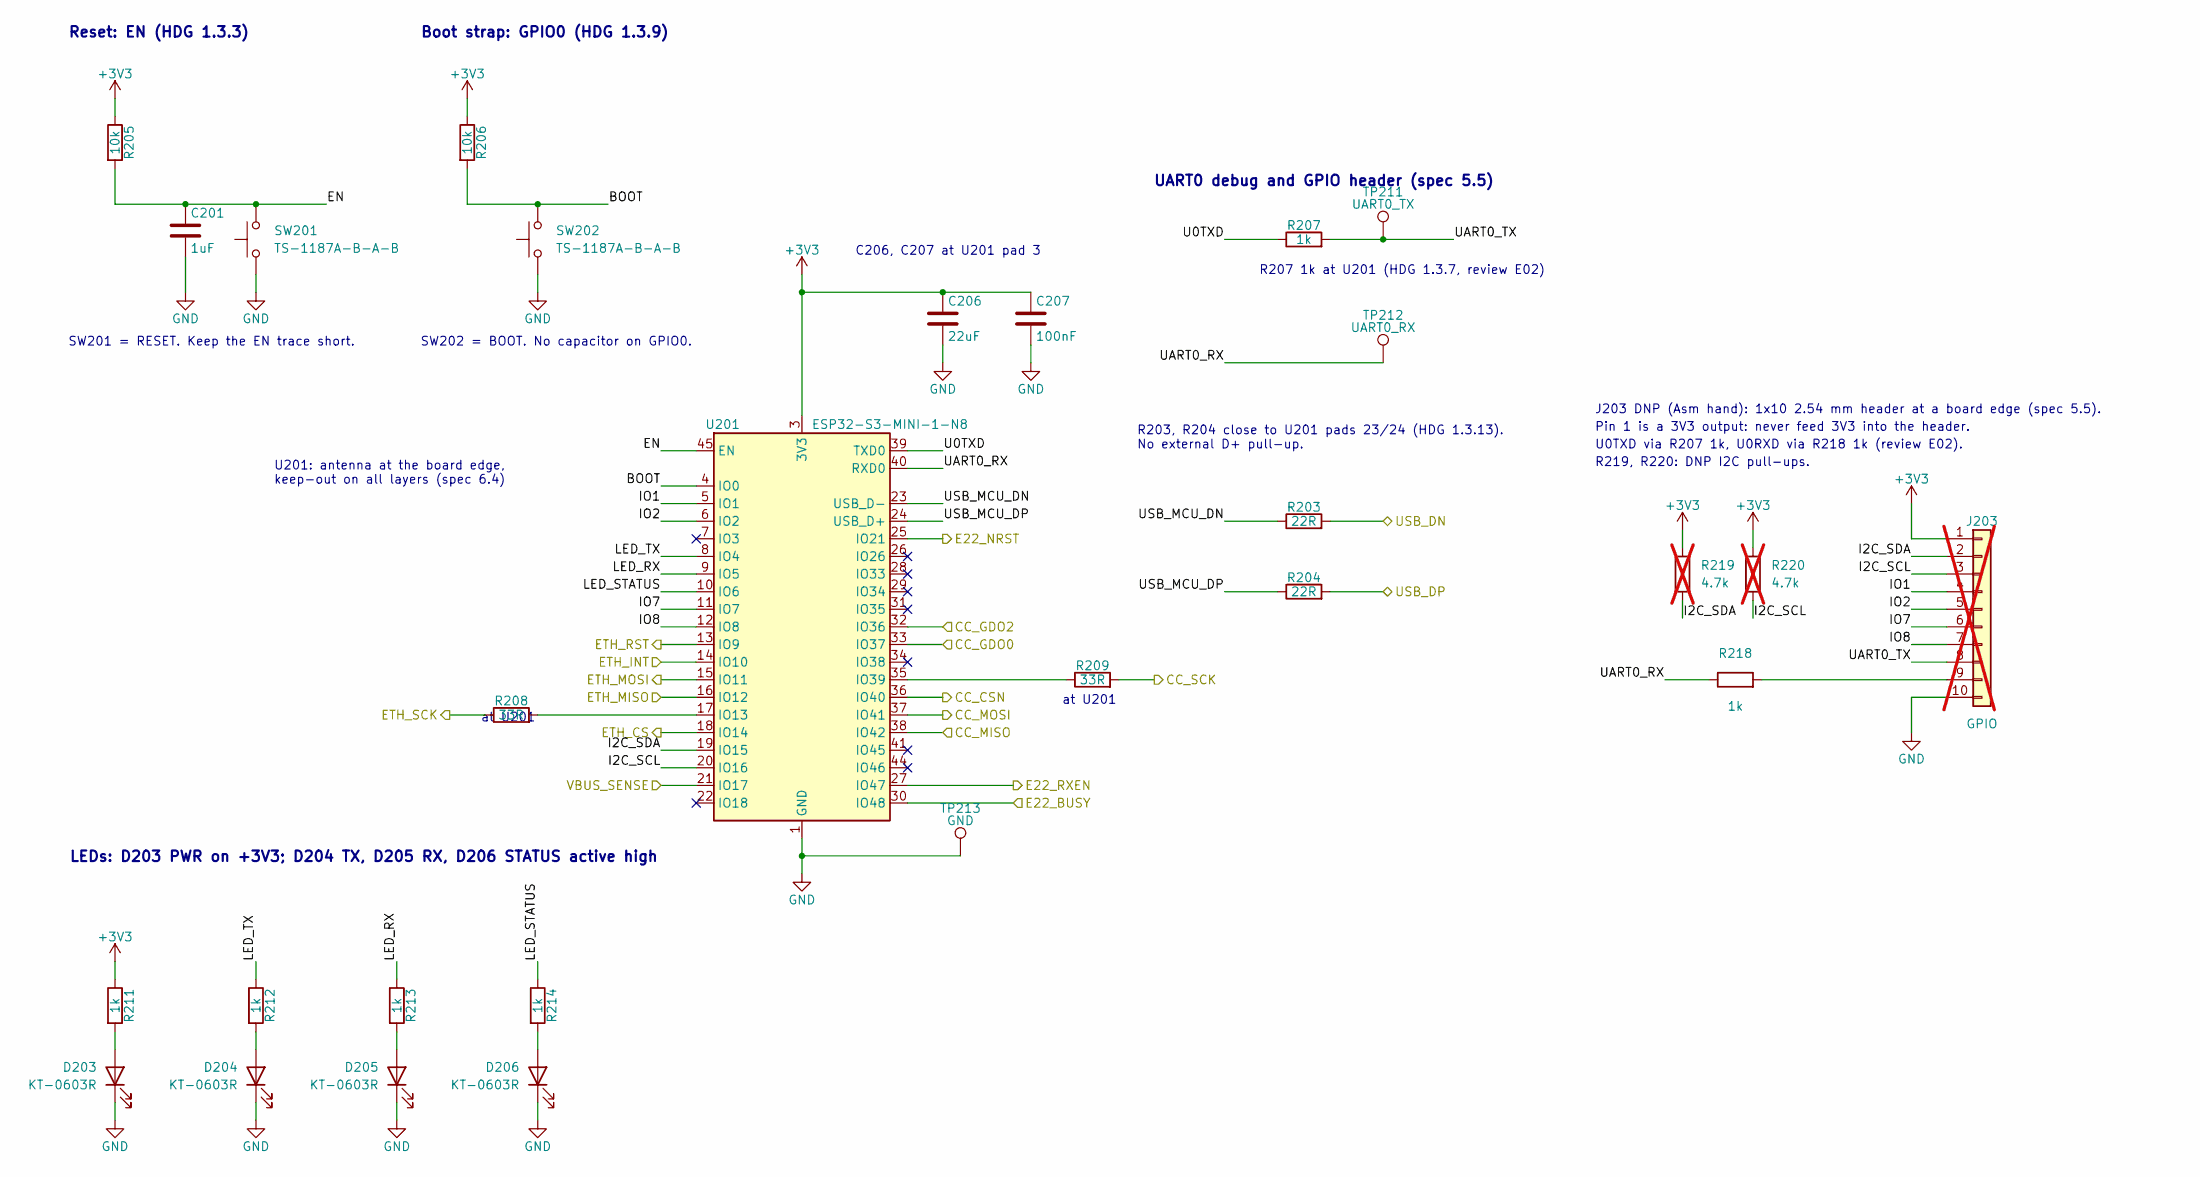
[picture p7: schematic mcu.kicad_sch, freedo radio rev A: MCU]

Parts:
C201: 1uF; C_0603_1608Metric; MPN CL10A105KB8NNNC; LCSC C15849
C206: 22uF; C_0603_1608Metric; MPN CL10A226MQ8NRNC; LCSC C59461
C207: 100nF; C_0603_1608Metric; MPN CC0603KRX7R9BB104; LCSC C14663
D203, D204, D205, D206: KT-0603R; LED_0603_1608Metric; MPN KT-0603R; LCSC C2286
J203: GPIO; PinHeader_1x10_P2.54mm_Vertical; not fitted
R203, R204: 22R; R_0603_1608Metric; MPN 0603WAF220JT5E; LCSC C23345
R205, R206: 10k; R_0603_1608Metric; MPN 0603WAF1002T5E; LCSC C25804
R207, R211, R212, R213, R214, R218: 1k; R_0603_1608Metric; MPN 0603WAF1001T5E; LCSC C21190
R208, R209: 33R; R_0603_1608Metric; MPN 0603WAF330JT5E; LCSC C23140
R219, R220: 4.7k; R_0603_1608Metric; MPN 0603WAF4701T5E; LCSC C23162; not fitted
SW201, SW202: TS-1187A-B-A-B; SW_XKB_TS-1187A; MPN TS-1187A-B-A-B; LCSC C318884
TP211: UART0_TX; TestPoint_Pad_D1.5mm
TP212: UART0_RX; TestPoint_Pad_D1.5mm
TP213: GND; TestPoint_Pad_D1.5mm
U201: ESP32-S3-MINI-1-N8; ESP32-S3-MINI-1; MPN ESP32-S3-MINI-1-N8; LCSC C2913206

Connections:
+3V3: C206.1, C207.1, J203.1, R205.1, R206.1, R211.1, R219.1, R220.1, U201.3 (3V3); also elsewhere on the board
/ethernet_poe/ETH_CS: U201.18 (IO14); also elsewhere on the board
/ethernet_poe/ETH_INT: U201.14 (IO10); also elsewhere on the board
/ethernet_poe/ETH_MISO: U201.16 (IO12); also elsewhere on the board
/ethernet_poe/ETH_MOSI: U201.15 (IO11); also elsewhere on the board
/ethernet_poe/ETH_RST: U201.13 (IO9); also elsewhere on the board
/ethernet_poe/ETH_SCK: R208.1; also elsewhere on the board
/mcu/BOOT: R206.2, SW202.2, U201.4 (IO0)
/mcu/CC_CSN: U201.36 (IO40); also elsewhere on the board
/mcu/CC_GDO0: U201.33 (IO37); also elsewhere on the board
/mcu/CC_GDO2: U201.32 (IO36); also elsewhere on the board
/mcu/CC_MISO: U201.38 (IO42); also elsewhere on the board
/mcu/CC_MOSI: U201.37 (IO41); also elsewhere on the board
/mcu/CC_SCK: R209.2; also elsewhere on the board
/mcu/E22_BUSY: U201.30 (IO48); also elsewhere on the board
/mcu/E22_NRST: U201.25 (IO21); also elsewhere on the board
/mcu/E22_RXEN: U201.27 (IO47); also elsewhere on the board
/mcu/EN: C201.1, R205.2, SW201.2, U201.45 (EN)
/mcu/I2C_SCL: J203.3, R220.2, U201.20 (IO16)
/mcu/I2C_SDA: J203.2, R219.2, U201.19 (IO15)
/mcu/IO1: J203.4, U201.5 (IO1)
/mcu/IO2: J203.5, U201.6 (IO2)
/mcu/IO7: J203.6, U201.11 (IO7)
/mcu/IO8: J203.7, U201.12 (IO8)
/mcu/LED_RX: R213.1, U201.9 (IO5)
/mcu/LED_STATUS: R214.1, U201.10 (IO6)
/mcu/LED_TX: R212.1, U201.8 (IO4)
/mcu/U0TXD: R207.1, U201.39 (TXD0)
/mcu/UART0_RX: R218.1, TP212.1, U201.40 (RXD0)
/mcu/UART0_TX: J203.8, R207.2, TP211.1
/mcu/USB_MCU_DN: R203.1, U201.23 (USB_D-)
/mcu/USB_MCU_DP: R204.1, U201.24 (USB_D+)
/mcu/VBUS_SENSE: U201.21 (IO17); also elsewhere on the board
/usb_power/USB_DN: R203.2; also elsewhere on the board
/usb_power/USB_DP: R204.2; also elsewhere on the board
GND: C201.2, C206.2, C207.2, D203.1 (K), D204.1 (K), D205.1 (K), D206.1 (K), J203.10, SW201.1, SW202.1, TP213.1, U201.1 (GND), U201.2 (GND), U201.42 (GND), U201.43 (GND), U201.46 (GND), U201.47 (GND), U201.48 (GND), U201.49 (GND), U201.50 (GND), U201.51 (GND), U201.52 (GND), U201.53 (GND), U201.54 (GND), U201.55 (GND), U201.56 (GND), U201.57 (GND), U201.58 (GND), U201.59 (GND), U201.60 (GND), U201.61 (GND), U201.62 (GND), U201.63 (GND), U201.64 (GND), U201.65 (GND); also elsewhere on the board
unnamed: D203.2 (A), R211.2
unnamed: D204.2 (A), R212.2
unnamed: D205.2 (A), R213.2
unnamed: D206.2 (A), R214.2
unnamed: J203.9, R218.2
unnamed: R208.2, U201.17 (IO13)
unnamed: R209.1, U201.35 (IO39)

Notes on the sheet:
U201: antenna at the board edge, keep-out on all layers (spec 6.4)
C206, C207 at U201 pad 3
Reset: EN (HDG 1.3.3)
SW201 = RESET. Keep the EN trace short.
Boot strap: GPIO0 (HDG 1.3.9)
SW202 = BOOT. No capacitor on GPIO0.
R203, R204 close to U201 pads 23/24 (HDG 1.3.13). No external D+ pull-up.
at U201
R207 1k at U201 (HDG 1.3.7, review E02)
UART0 debug and GPIO header (spec 5.5)
LEDs: D203 PWR on +3V3; D204 TX, D205 RX, D206 STATUS active high
J203 DNP (Asm hand): 1x10 2.54 mm header at a board edge (spec 5.5).
Pin 1 is a 3V3 output: never feed 3V3 into the header.
U0TXD via R207 1k, U0RXD via R218 1k (review E02).
R219, R220: DNP I2C pull-ups.

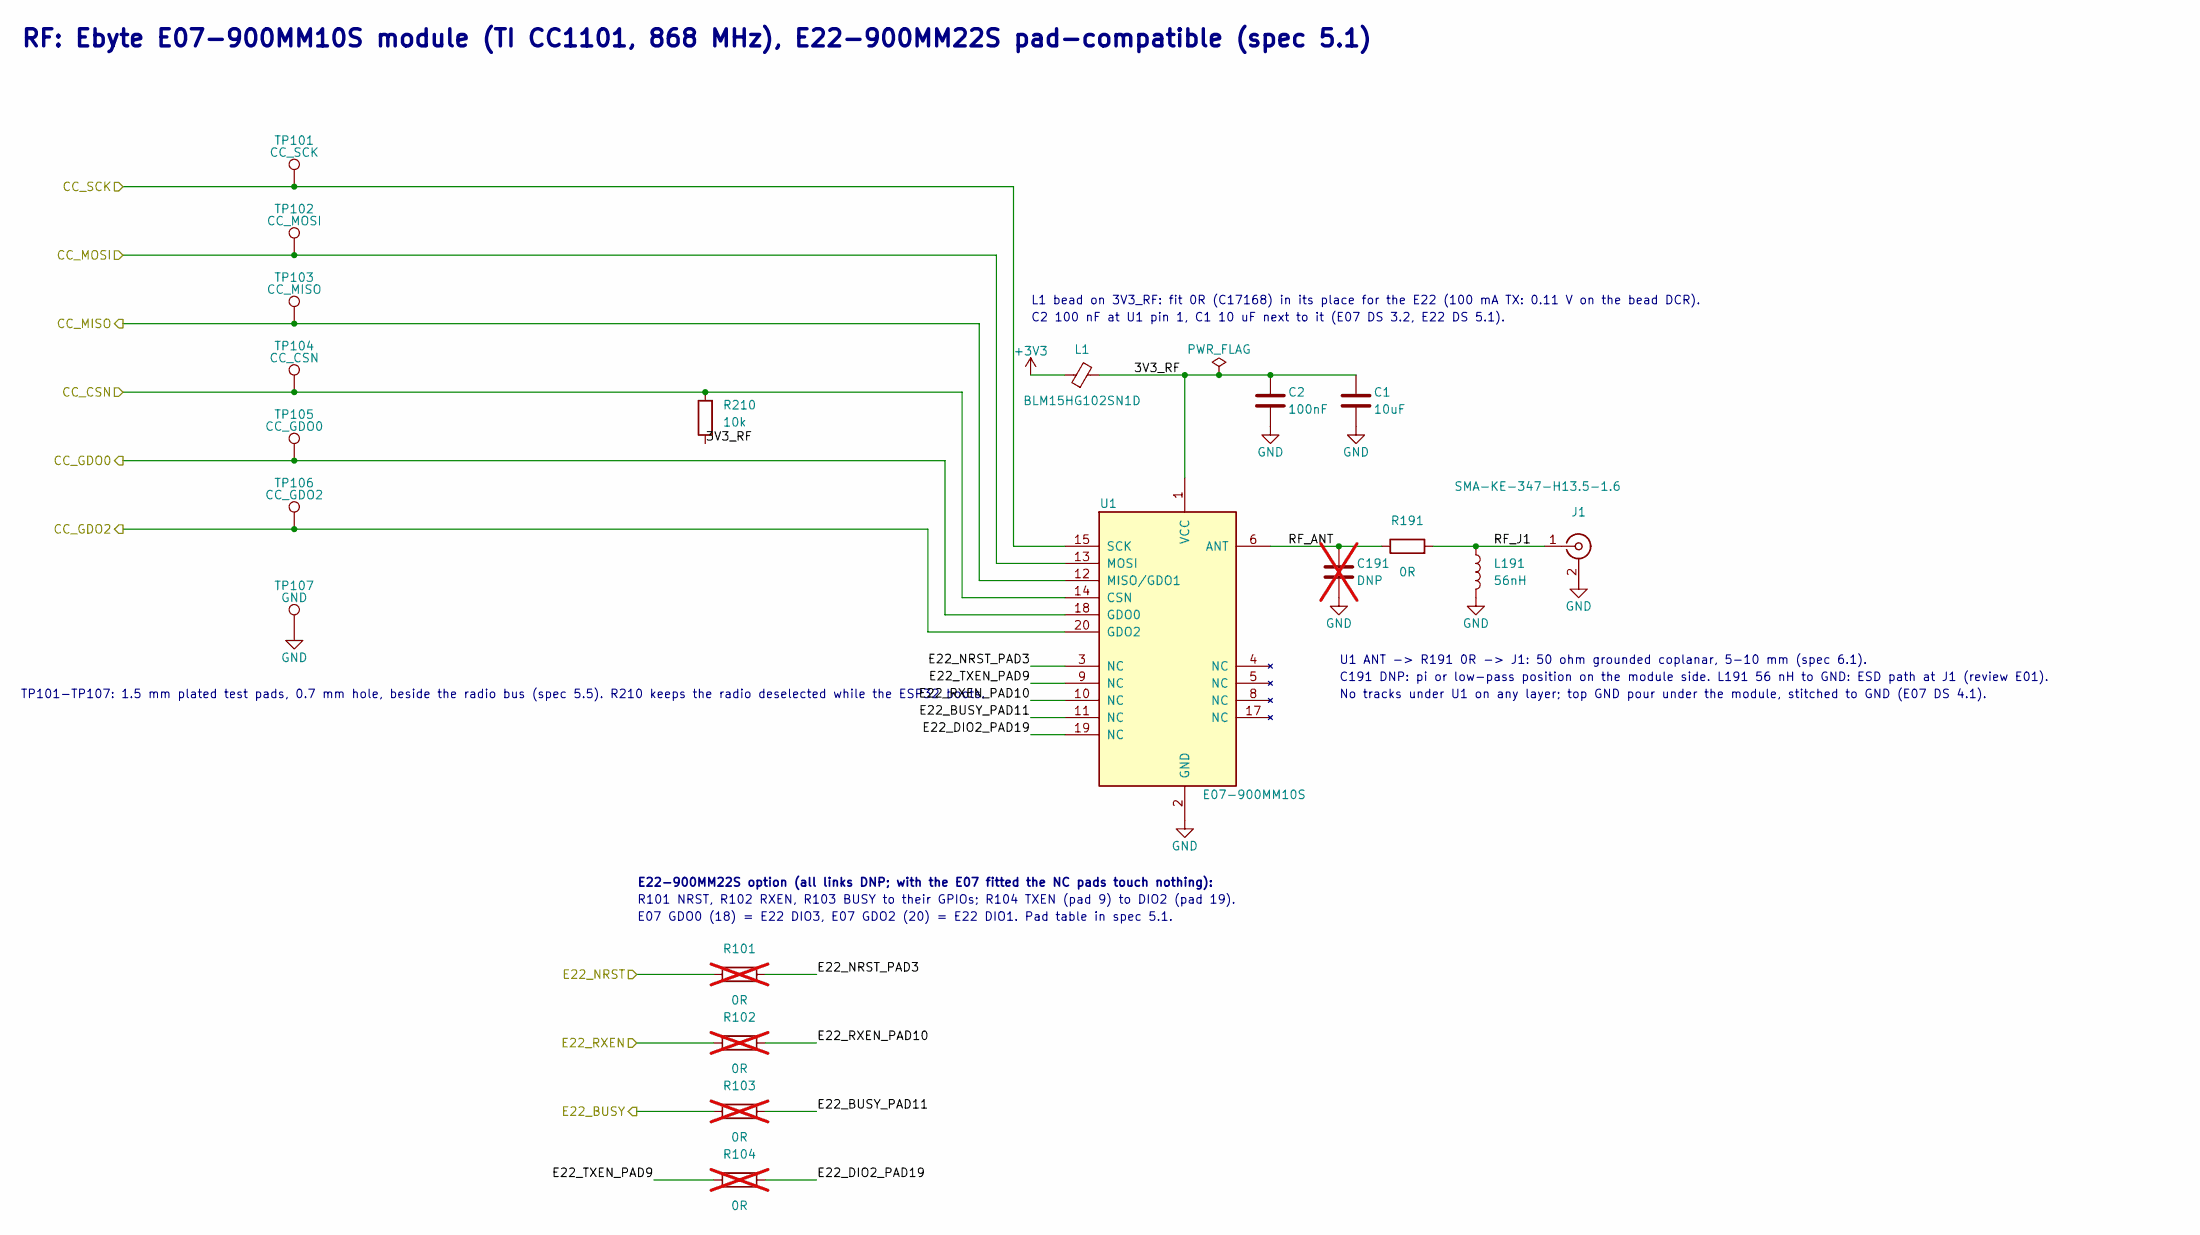
[picture p8: schematic rf.kicad_sch, freedo radio rev A: RF, E07-900MM10S 868 MHz]

Parts:
C1: 10uF; C_0603_1608Metric; MPN CL10A106KP8NNNC; LCSC C19702
C2: 100nF; C_0603_1608Metric; MPN CC0603KRX7R9BB104; LCSC C14663
C191: DNP; C_0402_1005Metric; not fitted
J1: SMA-KE-347-H13.5-1.6; SMA_XUNPU_SMA-KE-347-H13.5-1.6_EdgeMount; MPN SMA-KE-347-H13.5-1.6; LCSC C5723200
L1: BLM15HG102SN1D; L_0402_1005Metric; MPN BLM15HG102SN1D; LCSC C76889
L191: 56nH; L_0402_1005Metric; MPN LQW15AN56NG00D; LCSC C167482
R101, R102, R103, R104: 0R; R_0603_1608Metric; MPN 0603WAF0000T5E; LCSC C21189; not fitted
R191: 0R; R_0402_1005Metric; MPN 0402WGF0000TCE; LCSC C17168
R210: 10k; R_0603_1608Metric; MPN 0603WAF1002T5E; LCSC C25804
TP101: CC_SCK; TestPoint_THTPad_D1.5mm_Drill0.7mm
TP102: CC_MOSI; TestPoint_THTPad_D1.5mm_Drill0.7mm
TP103: CC_MISO; TestPoint_THTPad_D1.5mm_Drill0.7mm
TP104: CC_CSN; TestPoint_THTPad_D1.5mm_Drill0.7mm
TP105: CC_GDO0; TestPoint_THTPad_D1.5mm_Drill0.7mm
TP106: CC_GDO2; TestPoint_THTPad_D1.5mm_Drill0.7mm
TP107: GND; TestPoint_THTPad_D1.5mm_Drill0.7mm
U1: E07-900MM10S; Ebyte_LCC-20_10x10mm_P1.27mm_E07-MM10S_E22-MM22S; MPN E07-900MM10S; LCSC C5844212

Connections:
+3V3: L1.1; also elsewhere on the board
/mcu/CC_CSN: R210.2, TP104.1, U1.14 (CSN); also elsewhere on the board
/mcu/CC_GDO0: TP105.1, U1.18 (GDO0); also elsewhere on the board
/mcu/CC_GDO2: TP106.1, U1.20 (GDO2); also elsewhere on the board
/mcu/CC_MISO: TP103.1, U1.12 (MISO/GDO1); also elsewhere on the board
/mcu/CC_MOSI: TP102.1, U1.13 (MOSI); also elsewhere on the board
/mcu/CC_SCK: TP101.1, U1.15 (SCK); also elsewhere on the board
/mcu/E22_BUSY: R103.1; also elsewhere on the board
/mcu/E22_NRST: R101.1; also elsewhere on the board
/mcu/E22_RXEN: R102.1; also elsewhere on the board
/rf/3V3_RF: C1.1, C2.1, L1.2, R210.1, U1.1 (VCC)
/rf/E22_BUSY_PAD11: R103.2, U1.11 (NC)
/rf/E22_DIO2_PAD19: R104.2, U1.19 (NC)
/rf/E22_NRST_PAD3: R101.2, U1.3 (NC)
/rf/E22_RXEN_PAD10: R102.2, U1.10 (NC)
/rf/E22_TXEN_PAD9: R104.1, U1.9 (NC)
/rf/RF_ANT: C191.1, R191.1, U1.6 (ANT)
/rf/RF_J1: J1.1 (In), L191.1, R191.2
GND: C1.2, C2.2, C191.2, J1.2 (Ext), L191.2, TP107.1, U1.2 (GND), U1.7 (GND), U1.16 (GND); also elsewhere on the board

Notes on the sheet:
RF: Ebyte E07-900MM10S module (TI CC1101, 868 MHz), E22-900MM22S pad-compatible (spec 5.1)
TP101-TP107: 1.5 mm plated test pads, 0.7 mm hole, beside the radio bus (spec 5.5). R210 keeps the radio deselected while the ESP32 boots.
L1 bead on 3V3_RF: fit 0R (C17168) in its place for the E22 (100 mA TX: 0.11 V on the bead DCR).
C2 100 nF at U1 pin 1, C1 10 uF next to it (E07 DS 3.2, E22 DS 5.1).
U1 ANT -> R191 0R -> J1: 50 ohm grounded coplanar, 5-10 mm (spec 6.1).
C191 DNP: pi or low-pass position on the module side. L191 56 nH to GND: ESD path at J1 (review E01).
No tracks under U1 on any layer; top GND pour under the module, stitched to GND (E07 DS 4.1).
E22-900MM22S option (all links DNP; with the E07 fitted the NC pads touch nothing):
R101 NRST, R102 RXEN, R103 BUSY to their GPIOs; R104 TXEN (pad 9) to DIO2 (pad 19).
E07 GDO0 (18) = E22 DIO3, E07 GDO2 (20) = E22 DIO1. Pad table in spec 5.1.

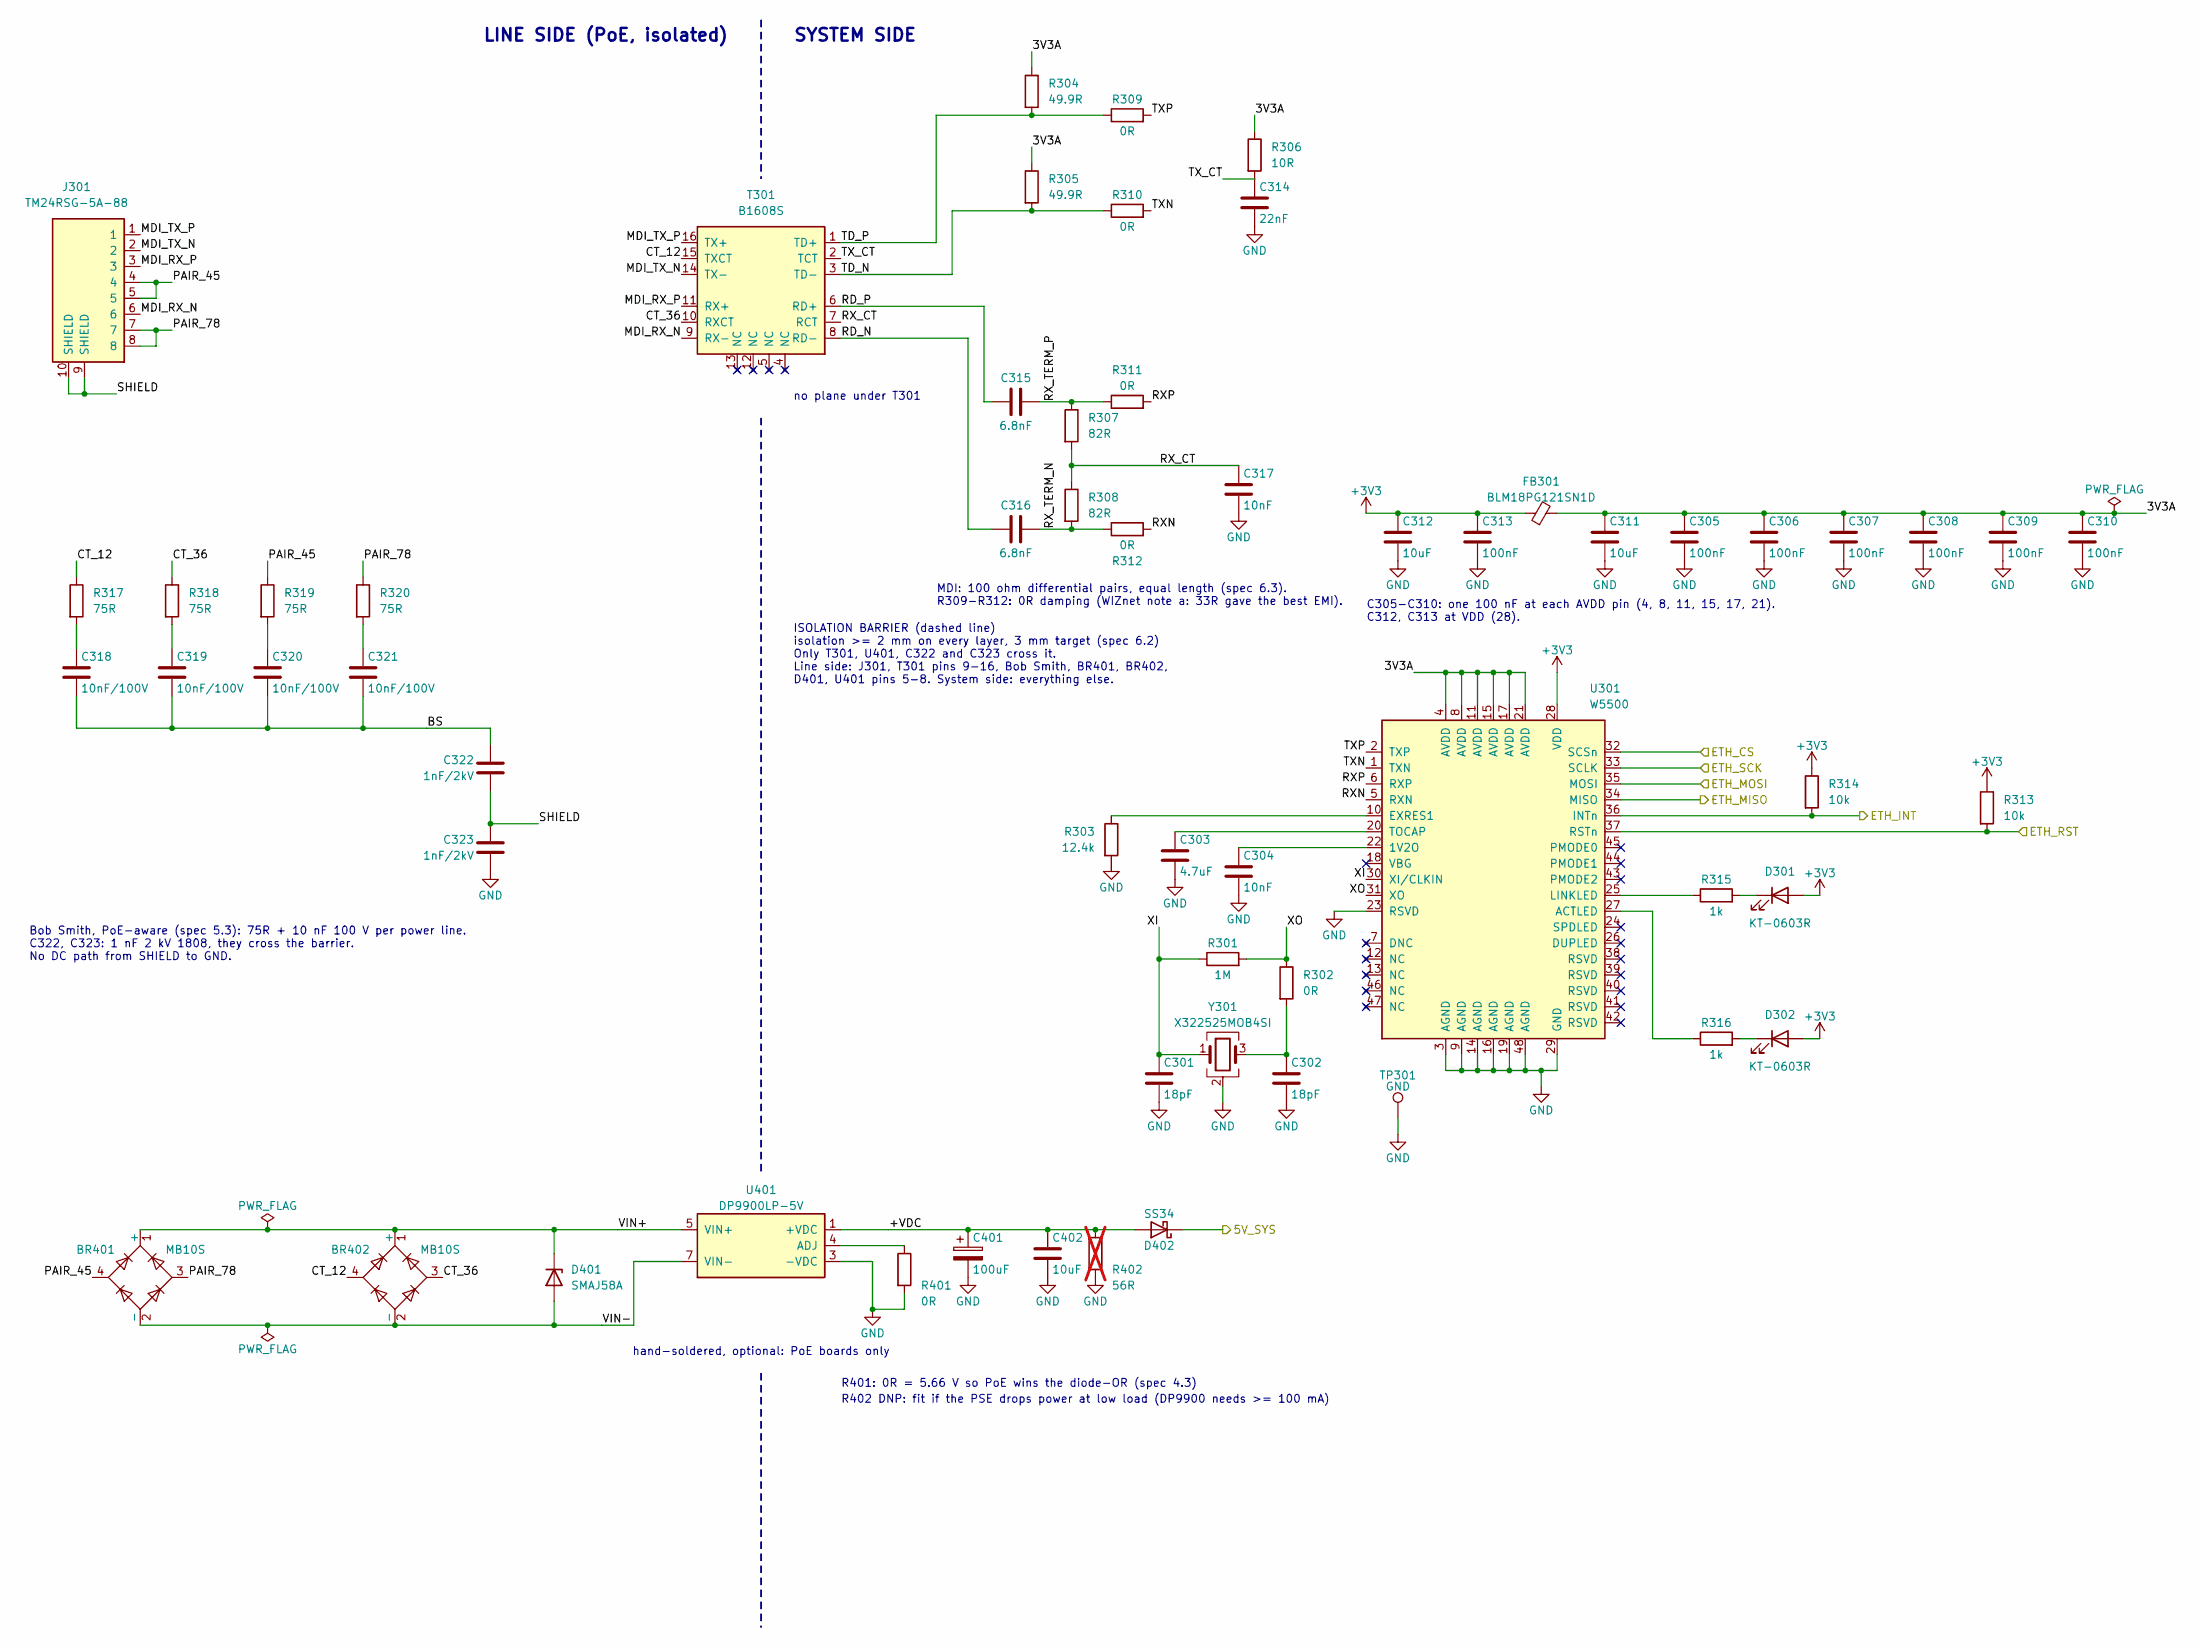
[picture p9: schematic ethernet_poe.kicad_sch, freedo radio rev A: Ethernet and PoE]

Parts:
BR401, BR402: MB10S; MBS_L4.7-W3.8-P2.40-LS7.0-TL; MPN MB10S (MDD); LCSC C2488
C301, C302: 18pF; C_0603_1608Metric; MPN CL10C180JB8NNNC; LCSC C1647
C303: 4.7uF; C_0603_1608Metric; MPN CL10A475KO8NNNC; LCSC C19666
C304, C317: 10nF; C_0603_1608Metric; MPN 0603B103K500NT; LCSC C57112
C305, C306, C307, C308, C309, C310, C313: 100nF; C_0603_1608Metric; MPN CC0603KRX7R9BB104; LCSC C14663
C311, C312: 10uF; C_0603_1608Metric; MPN CL10A106KP8NNNC; LCSC C19702
C314: 22nF; C_0603_1608Metric; MPN CL10B223KB8NNNC; LCSC C21122
C315, C316: 6.8nF; C_0603_1608Metric; MPN 0603B682K500NT; LCSC C1631
C318, C319, C320, C321: 10nF/100V; C_0603_1608Metric; MPN 0603B103K101NT; LCSC C43253
C322, C323: 1nF/2kV; C_1808_4520Metric; MPN 1808B102K202NT; LCSC C81332
C401: 100uF; CP_Elec_6.3x7.7; MPN EEHZA1E101XP; LCSC C264047
C402: 10uF; C_0805_2012Metric; MPN CL21A106KAYNNNE; LCSC C15850
D301, D302: KT-0603R; LED_0603_1608Metric; MPN KT-0603R; LCSC C2286
D401: SMAJ58A; SMA_L4.3-W2.6-LS5.2-RD; MPN SMAJ58A (MDD); LCSC C123816
D402: SS34; SMA_L4.3-W2.6-LS5.2-RD; MPN SS34; LCSC C8678
FB301: BLM18PG121SN1D; L_0603_1608Metric; MPN BLM18PG121SN1D; LCSC C14709
J301: TM24RSG-5A-88; RJ45_Hirose_TM24RSG-5A-88; MPN TM24RSG-5A-88; LCSC C6285250
R301: 1M; R_0603_1608Metric; MPN 0603WAF1004T5E; LCSC C22935
R302, R309, R310, R311, R312, R401: 0R; R_0603_1608Metric; MPN 0603WAF0000T5E; LCSC C21189
R303: 12.4k; R_0603_1608Metric; MPN 0603WAF1242T5E; LCSC C22865
R304, R305: 49.9R; R_0603_1608Metric; MPN 0603WAF499JT5E; LCSC C23185
R306: 10R; R_0603_1608Metric; MPN 0603WAF100JT5E; LCSC C22859
R307, R308: 82R; R_0603_1608Metric; MPN 0603WAF820JT5E; LCSC C23255
R313, R314: 10k; R_0603_1608Metric; MPN 0603WAF1002T5E; LCSC C25804
R315, R316: 1k; R_0603_1608Metric; MPN 0603WAF1001T5E; LCSC C21190
R317, R318, R319, R320: 75R; R_0603_1608Metric; MPN 0603WAF750JT5E; LCSC C4275
R402: 56R; R_2512_6332Metric; MPN MCR100JZHJ560; LCSC C308356; not fitted
T301: B1608S; CND-tek_B1608S_SMD-16_P1.27mm; MPN B1608S; LCSC C507596
TP301: GND; TestPoint_Pad_D1.5mm
U301: W5500; LQFP-48_L7.0-W7.0-P0.50-LS9.0-BL; MPN W5500; LCSC C32843
U401: DP9900LP-5V; SDAPO_DP9900LP_THT-8; MPN DP9900LP-5V; LCSC C5380108
Y301: X322525MOB4SI; CRYSTAL-SMD_4P-L3.2-W2.5-BL; MPN X322525MOB4SI; LCSC C9006

Connections:
+3V3: C312.1, C313.1, D301.2 (A), D302.2 (A), FB301.1, R313.1, R314.1, U301.28 (VDD); also elsewhere on the board
/ethernet_poe/3V3A: C305.1, C306.1, C307.1, C308.1, C309.1, C310.1, C311.1, FB301.2, R304.1, R305.1, R306.1, U301.4 (AVDD), U301.8 (AVDD), U301.11 (AVDD), U301.15 (AVDD), U301.17 (AVDD), U301.21 (AVDD)
/ethernet_poe/5V_SYS: D402.1 (K); also elsewhere on the board
/ethernet_poe/+VDC: C401.1, C402.1, D402.2 (A), R402.1, U401.1 (+VDC), U401.2 (+VDC)
/ethernet_poe/BS: C318.2, C319.2, C320.2, C321.2, C322.1
/ethernet_poe/CT_12: BR402.4, R317.1, T301.15 (TXCT)
/ethernet_poe/CT_36: BR402.3, R318.1, T301.10 (RXCT)
/ethernet_poe/ETH_CS: U301.32 (SCSn); also elsewhere on the board
/ethernet_poe/ETH_INT: R314.2, U301.36 (INTn); also elsewhere on the board
/ethernet_poe/ETH_MISO: U301.34 (MISO); also elsewhere on the board
/ethernet_poe/ETH_MOSI: U301.35 (MOSI); also elsewhere on the board
/ethernet_poe/ETH_RST: R313.2, U301.37 (RSTn); also elsewhere on the board
/ethernet_poe/ETH_SCK: U301.33 (SCLK); also elsewhere on the board
/ethernet_poe/MDI_RX_N: J301.6, T301.9 (RX-)
/ethernet_poe/MDI_RX_P: J301.3, T301.11 (RX+)
/ethernet_poe/MDI_TX_N: J301.2, T301.14 (TX-)
/ethernet_poe/MDI_TX_P: J301.1, T301.16 (TX+)
/ethernet_poe/PAIR_45: BR401.4, J301.4, J301.5, R319.1
/ethernet_poe/PAIR_78: BR401.3, J301.7, J301.8, R320.1
/ethernet_poe/RD_N: C316.1, T301.8 (RD-)
/ethernet_poe/RD_P: C315.1, T301.6 (RD+)
/ethernet_poe/RXN: R312.2, U301.5 (RXN)
/ethernet_poe/RXP: R311.2, U301.6 (RXP)
/ethernet_poe/RX_CT: C317.1, R307.2, R308.1, T301.7 (RCT)
/ethernet_poe/RX_TERM_N: C316.2, R308.2, R312.1
/ethernet_poe/RX_TERM_P: C315.2, R307.1, R311.1
/ethernet_poe/SHIELD: C322.2, C323.1, J301.9 (SHIELD), J301.10 (SHIELD), J301.11 (SHIELD), J301.12 (SHIELD), J301.13 (SHIELD), J301.14 (SHIELD)
/ethernet_poe/TD_N: R305.2, R310.1, T301.3 (TD-)
/ethernet_poe/TD_P: R304.2, R309.1, T301.1 (TD+)
/ethernet_poe/TXN: R310.2, U301.1 (TXN)
/ethernet_poe/TXP: R309.2, U301.2 (TXP)
/ethernet_poe/TX_CT: C314.1, R306.2, T301.2 (TCT)
/ethernet_poe/VIN+: BR401.1 (+), BR402.1 (+), D401.1 (K), U401.5 (VIN+), U401.6 (VIN+)
/ethernet_poe/VIN-: BR401.2 (-), BR402.2 (-), D401.2 (A), U401.7 (VIN-), U401.8 (VIN-)
/ethernet_poe/XI: C301.1, R301.1, U301.30 (XI/CLKIN), Y301.1
/ethernet_poe/XO: R301.2, R302.1, U301.31 (XO)
GND: C301.2, C302.2, C303.2, C304.2, C305.2, C306.2, C307.2, C308.2, C309.2, C310.2, C311.2, C312.2, C313.2, C314.2, C317.2, C323.2, C401.2, C402.2, R303.2, R401.2, R402.2, TP301.1, U301.3 (AGND), U301.9 (AGND), U301.14 (AGND), U301.16 (AGND), U301.19 (AGND), U301.23 (RSVD), U301.29 (GND), U301.48 (AGND), U401.3 (-VDC), Y301.2 (G), Y301.4 (G); also elsewhere on the board
unnamed: C302.1, R302.2, Y301.3
unnamed: C318.1, R317.2
unnamed: C319.1, R318.2
unnamed: C320.1, R319.2
unnamed: C321.1, R320.2
unnamed: D301.1 (K), R315.2
unnamed: D302.1 (K), R316.2
unnamed: C304.1, U301.22 (1V2O)
unnamed: R316.1, U301.27 (ACTLED)
unnamed: R303.1, U301.10 (EXRES1)
unnamed: R315.1, U301.25 (LINKLED)
unnamed: C303.1, U301.20 (TOCAP)
unnamed: R401.1, U401.4 (ADJ)

Notes on the sheet:
LINE SIDE (PoE, isolated)
SYSTEM SIDE
ISOLATION BARRIER (dashed line) isolation >= 2 mm on every layer, 3 mm target (spec 6.2) Only T301, U401, C322 and C323 cross it. Line side: J301, T301 pins 9-16, Bob Smith, BR401, BR402, D401, U401 pins 5-8. System side: everything else.
no plane under T301
hand-soldered, optional: PoE boards only
R401: 0R = 5.66 V so PoE wins the diode-OR (spec 4.3)
Bob Smith, PoE-aware (spec 5.3): 75R + 10 nF 100 V per power line. C322, C323: 1 nF 2 kV 1808, they cross the barrier. No DC path from SHIELD to GND.
C305-C310: one 100 nF at each AVDD pin (4, 8, 11, 15, 17, 21). C312, C313 at VDD (28).
MDI: 100 ohm differential pairs, equal length (spec 6.3). R309-R312: 0R damping (WIZnet note a: 33R gave the best EMI).
R402 DNP: fit if the PSE drops power at low load (DP9900 needs >= 100 mA)

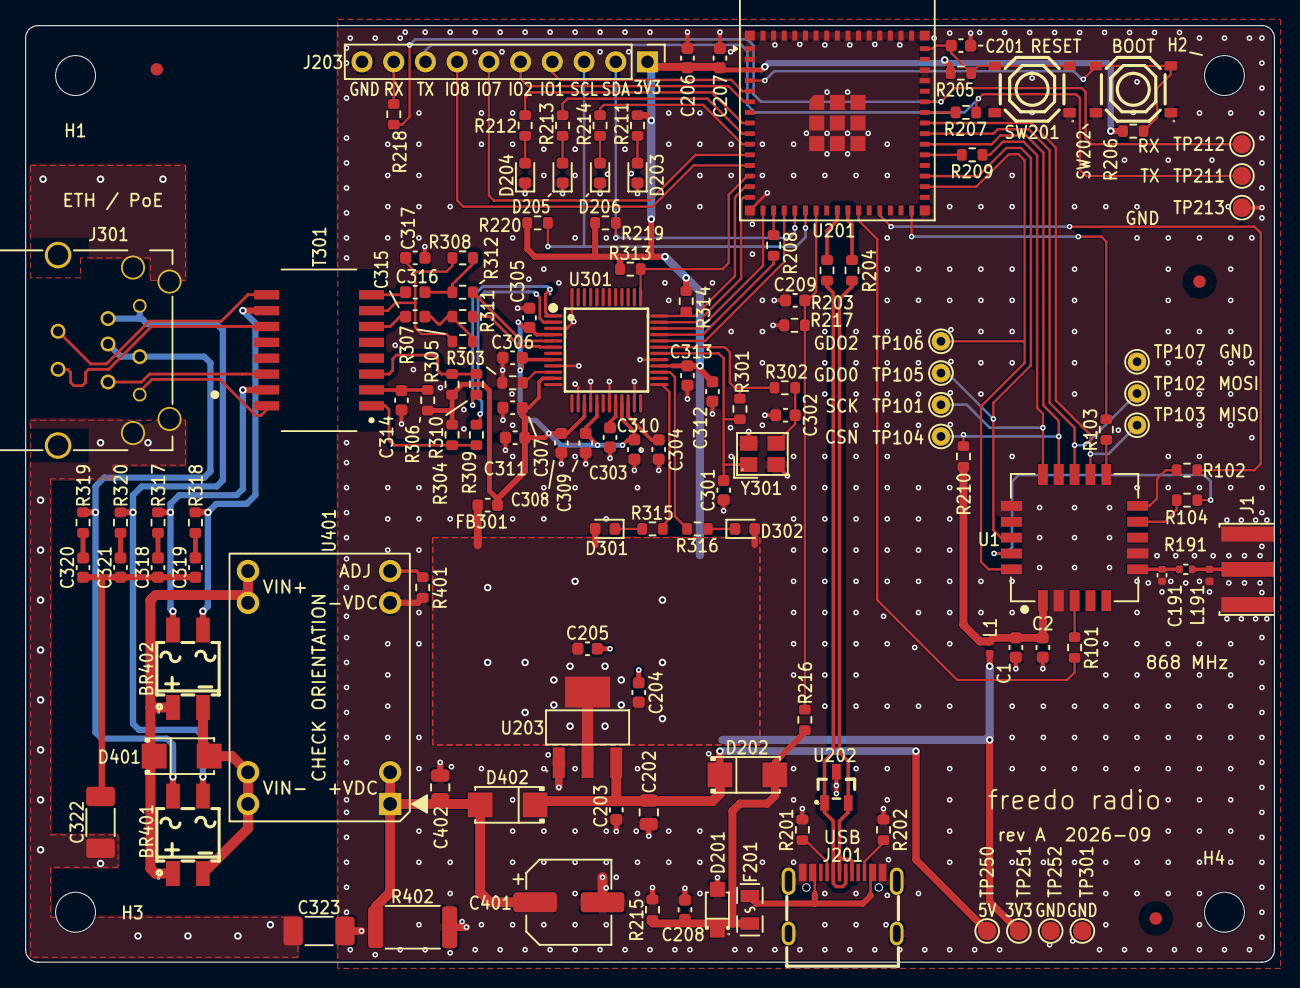
[picture p10: board freedo-radio.kicad_pcb from above]

Board: 4 copper layers, 100.0 x 75.0 mm, 135 parts (0 on the bottom side), 97 nets.

Other parts of the board:
FID1, FID2, FID3: Fiducial; Fiducial_1mm_Mask2mm
H1, H2, H3, H4: MountingHole_3.2mm_M3
