CappyT/freedo/(commit log)

2026-09-24 feat(hardware): draw the rev a schematic
2026-09-24 fix(hardware): apply the schematic review findings
2026-09-24 test: pin hot water home and away and the daily program
2026-09-24 feat(hardware): set up the board stackup, rules and outline
2026-09-24 feat(hardware): place the rev a footprints
2026-09-24 fix: key overlay timers by zone and restate a pending return from off
2026-09-24 fix(ha): correct climate temperature, pending targets and hub device
2026-09-24 fix: harden reassembly, mid 0, option relay, enhanced ack and block2 serving
2026-09-24 feat(hardware): route the critical nets and ground planes
2026-09-24 fix: move schedules with members, decode pid strictly and save before engine changes
2026-09-24 fix(tado): end overlay timers on delivery and keep wheel overlays and queued windows
2026-09-24 fix(hardware): drop the footprint lcsc part fields
2026-09-24 fix(hardware): apply the pcb review fixes and align the usb-c to the edge
2026-09-24 fix(tado): serve the thermostat calibration offset and trigger its reread
2026-09-24 fix(tado): take device overlay and window deletes, serve the thermostat without 015d and refuse its child lock
2026-09-24 fix(tado): relay zone messages verbatim and match captured answer options
2026-09-24 feat(hardware): generate the jlc fabrication and assembly files
2026-09-24 feat(tado): learn joining devices in a pair window and answer echo and neighbor solicitation
2026-09-25 feat: push schedule edits to the offline copy and add an ha offline schedule switch
2026-09-25 feat(hardware): move the radio to the ebyte e07 module and fix the power review findings
2026-09-25 feat(hardware): re-place the board with rework spacing
2026-09-25 feat(hardware): make both spi buses planar and move decoupling to its pins
2026-09-25 feat(hardware): route the board with bus highways and solid ground planes
2026-09-25 feat(hardware): add jlc rotations for the module parts and check bom and cpl sets
2026-09-25 fix(hardware): apply the routed-board review fixes
2026-10-11 feat(api): show the child lock state of a valve
2026-10-11 feat(ha): add a presence blueprint that drives the away switch
2026-10-11 feat(ha): add child lock, identify, calibration and offset controls for valves
2026-10-11 feat(ha): add zone settings for early start, open window and device end rule
2026-10-11 feat(ha): add firmware, device reading, zone demand and comms warning diagnostics
2026-10-11 feat(ha): add a flow limit number for each boiler circuit
2026-10-11 feat(tools): add a collector for the tado flow temperature adaptation
2026-10-11 feat(ha): add boiler energy and power sensors
2026-10-11 feat(daemon): add a per-zone away temperature
2026-10-11 fix(engine): set 6440 on a zone switch only when the target changes
2026-10-11 feat(ha): add an away temperature number for each heating zone
2026-10-11 feat(ha): add the schedule services to the water heater
2026-10-11 feat(ha): add a pairing mode switch on the hub
2026-10-11 feat(daemon): count boiler gas volume from the burner flow range
2026-10-11 feat(ha): add boiler gas volume sensors and flow settings
2026-10-11 fix(log): redact secret tags in the unhandled frame log
2026-10-11 feat(api): report the side effects of removing a device
2026-10-11 fix(api): keep device credentials out of the node views
2026-10-11 feat(ha): add heating activity sensors and report recipes
2026-10-11 feat(daemon): adapt the flow temperature limit to room feedback
2026-10-11 feat(daemon): regulate a zone on an external room temperature
2026-10-11 feat(daemon): serve no flow limit until one is set
2026-10-11 feat(daemon): cut the flow limit to the boiler maximum and serve the bounds
2026-10-11 fix(daemon): read the boiler capabilities from the first circuit without hot water
2026-10-11 fix(daemon): follow one heat source in the boiler energy meter
2026-10-11 fix(tado): build the zone config of a heating zone with no circuit
2026-10-11 test(tado): pin the utc offset of the synthetic install
2026-10-11 feat(daemon): add a default weather curve for the flow limit
2026-10-11 feat(integration): add flow limit default curve and adaptation switches
2026-10-11 feat(integration): map a room temperature sensor to a zone
2026-10-11 docs(integration): describe the room temperature sensor of a zone
2026-10-11 feat(integration): add the temperature offset mode select
2026-10-11 fix(radio): ask for the banner again when a reply is cut
2026-10-11 fix(firmware): clock the uart from apb
2026-10-11 docs(addon): add the room temperature sensor to the 0.3.1 changelog
2026-10-11 fix(daemon): state which offset modes home a valve in the room temperature error
2026-10-11 fix(integration): offer the temperature control on a zone with no target
2026-10-11 feat(dashboard): add the devices page
2026-10-12 feat(dashboard): rename a device from the devices page
2026-10-12 feat(integration): give the hot water zone device a translated name
2026-10-12 feat(daemon): keep the device firmware across restarts and read it once after start
2026-10-12 feat(integration): report the device firmware as the software version
2026-10-12 feat(daemon): learn the serial of a device declared without one
2026-10-12 feat(integration): choose the temperature source of each room
2026-10-12 feat(daemon): calibrate the zone correction from the external sensor
2026-10-12 feat(integration): switch the automatic correction and set its interval
2026-10-12 fix(daemon): sample the automatic correction at the engine tick rate
2026-10-12 fix(daemon): calibrate from the measuring device and stop when a write does not help
2026-10-12 fix(integration): write a new firmware to the device registry
2026-10-12 fix(integration): serialize a room temperature push with the pause
2026-10-12 fix(daemon): let ingress rename a device without changing its other fields
2026-10-12 fix(tado): restore firmware state only for declared devices
2026-10-12 ci(release): attach the daemon binaries to every release
2026-10-12 test: derive the newer schema version from the current one
2026-10-12 fix(daemon): leave away program zones out of the away temperature restate
2026-10-12 fix(dashboard): show a renamed device at once after the save
2026-10-12 fix(dashboard): align form buttons on the line of the controls
2026-10-12 fix(dashboard): keep command buttons and form rows tidy on desktop and phone
2026-10-12 fix(dashboard): keep the two buttons of the profile form on one line on a phone
2026-10-12 fix(dashboard): show the hot water temperature on its card instead of a second target
2026-10-12 docs: list the tado device lines and what freedo supports of each
2026-10-12 feat(daemon): label an external room temperature with its sensor
2026-10-12 feat(integration): map each zone to a home assistant area and its room sensor
2026-10-12 feat(blueprint): switch the active profile by season
2026-10-12 fix(integration): end the pause of a zone that gets a new sensor in the rooms step
2026-10-12 fix(integration): place zone devices only when the area changes or a device is new
2026-10-12 test(integration): expect the hot water device name of main
2026-10-12 fix(integration): give the zone devices a model name in words
2026-10-12 fix(integration): give the room sensor short states for the correction model
2026-10-12 fix(integration): make the manual offset unavailable during the valve calibration
2026-10-12 fix(integration): shorten the entity names so they fit a device page
2026-10-12 fix(integration): name the device change timer in italian and german
2026-10-12 feat(integration): add the identify button to the wall thermostat
2026-10-13 fix(daemon): list zone membership in the device removal preview
2026-10-13 feat(dashboard): add first setup and room and device management
2026-10-13 docs(protocol): document the fault word state codes of valve and thermostat
2026-10-13 feat: decode the fault word state code and report valve warnings apart from faults
2026-10-13 docs: describe the ingress installation routes, the device warnings and the plant status
2026-10-13 fix(daemon): clear the flow limit through a null flow_limit_c patch
2026-10-13 test(daemon): cover the refused flow limit clear under the default curve
2026-10-13 docs(protocol): document the network commands and how a device leaves the network
2026-10-13 docs: state that a device leaves its network only by its button
2026-10-13 feat(dashboard): move rename, room and removal of a device into the room settings
2026-10-13 feat(integration): configure each room in one form with its sensors
2026-10-13 docs: add a contents list to the readme and name the device section supported devices
2026-10-13 feat(blueprints): add the distance setback and the auxiliary heat
2026-10-13 feat(blueprint): add the monthly valve exercise
2026-10-13 docs: describe the valve exercise and the warmer outside reminder
2026-10-13 fix(dashboard): end the add device flow with one paired state
2026-10-13 docs: describe the end of the add device flow
2026-10-13 feat(dashboard): add the device restart and keep the room in the add device flow
2026-10-13 docs: describe the device restart, the session fields and the add device room
2026-10-21 chore: track the impeccable design brief and sidecar
2026-10-22 fix(dashboard): name the radio link warnings of a device
2026-10-22 fix(dashboard): show the home assistant outdoor temperature on the boiler page
2026-10-23 feat(dashboard): list the heating periods of a room in the report
2026-10-23 docs: describe the heating periods of the room report
2026-10-26 feat(daemon): the coordinator as the owner of a heating zone
2026-10-26 fix(daemon): reset the zone controller when its temperature source changes
2026-10-26 feat(homeassistant): offer the coordinator as the room temperature correction
2026-10-26 feat(dashboard): one temperature correction select with the coordinator as owner
2026-10-26 feat(daemon): keep the room temperature readings across a restart
2026-10-28 fix(daemon): apply the flow limit hysteresis before rounding
2026-10-28 feat(daemon): report the room temperature pushes a zone refuses
2026-10-28 feat(dashboard): show the room temperature source and its method
2026-10-28 docs: compare the room temperature methods
2026-10-30 feat(daemon): keep one room temperature source per zone
2026-10-30 feat(integration): choose the room temperature source with one select
2026-11-02 feat(daemon): measure the receiver calibration on the frames the radio hears
2026-11-02 feat(dashboard): show the receiver calibration in the setup and settings pages
2026-11-02 docs: describe the receiver calibration that the daemon measures itself
2026-11-02 fix(daemon): start the receiver at 0x34 and accept the live calibration inside 8 units
2026-11-02 docs: record the on-air bias of the live receiver calibration
2026-11-07 fix(tado): stop capping the flow limit at the dhw setpoint bound
2026-11-07 refactor(tado)!: name the boiler and valve telemetry after the firmware
2026-11-07 docs(protocol): document the 015e thermostat roles and the 4160 valve divisor
2026-11-07 fix(tado): refuse a flow limit that is not a whole degree
2026-11-07 docs: state that the thermostat writes no maxtset without a flow limit
2026-11-07 fix(dashboard): refuse a flow limit that is not a whole degree
2026-11-07 docs(protocol): state that the thermostat sends its sensor report for every role
2026-11-07 docs(protocol): trace the meaning of the d/dbg/m diagnostic values
2026-11-07 feat(tado): decode and read valve debug statistics
2026-11-07 feat(daemon): add the valve debug statistics routes
2026-11-07 feat(dashboard): show the radio diagnostics of a valve
2026-11-07 fix: count the valve radio counters between the last two reads
2026-11-07 feat(daemon): record the outdoor and indoor temperature in the statistics
2026-11-07 docs(protocol): record the two-read check of the valve debug statistics
2026-11-07 feat: add the radiator power of a heating zone
2026-11-07 feat(daemon): split the fuel by room and fit the heat loss of the house
2026-11-08 feat(daemon): add the shared space of heating zones
2026-11-08 feat(daemon): suggest where the heating spends too much
